el-nikitos/UAK/UAK_0/PNG/UAK_1A_Back.png

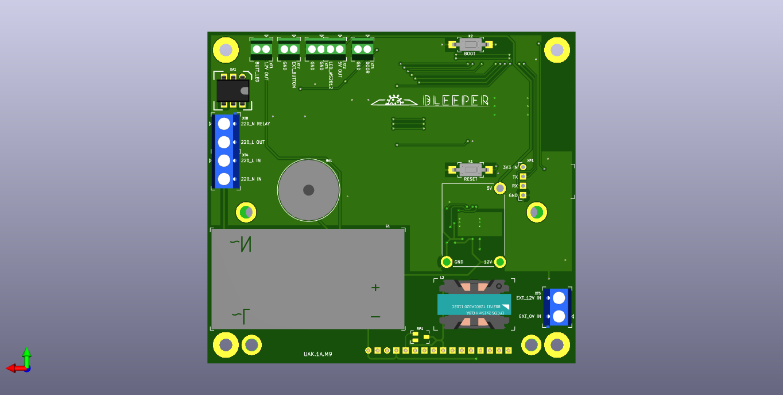
UAK_0/PNG/UAK_1A_Back.png
