el-nikitos/UAK/UAK_0/PNG/UAK_0B_Back.png

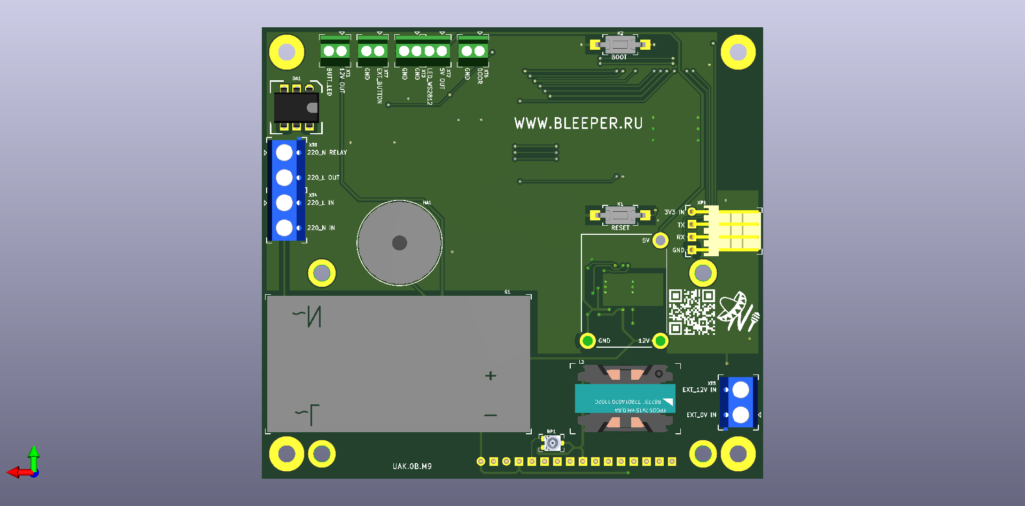
UAK_0/PNG/UAK_0B_Back.png
