el-nikitos/UAK/заводские номера/uak-1с.docx

uak-1c-1m0
uak-1c-2m0
uak-1c-3m0
uak-1c-4m0

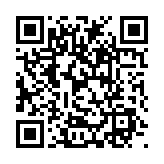
[picture p15: figure]

uak-1c-5m0

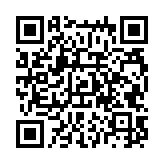
[picture p16: figure]

uak-1c-6m0

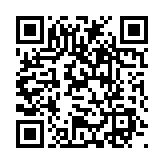
[picture p17: figure]

uak-1c-7m0

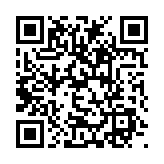
[picture p18: figure]

uak-1c-8m0

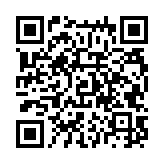
[picture p19: figure]

uak-1c-9m0
