el-nikitos/UAK/UAK_0/PNG/UAK_0_F_preview.png

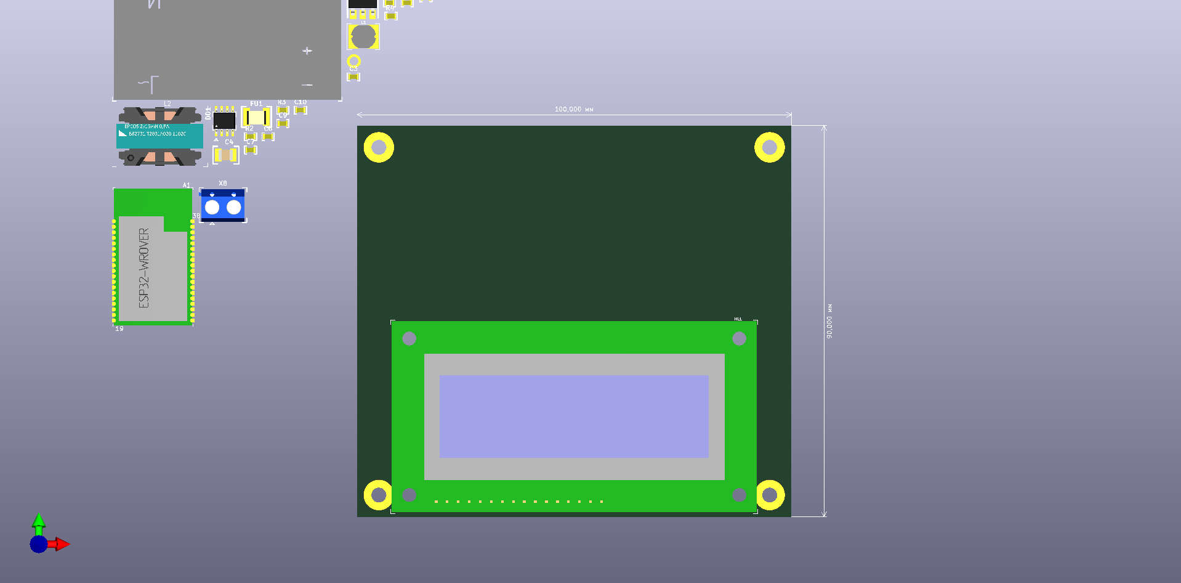
UAK_0/PNG/UAK_0_F_preview.png
