el-nikitos/UAK/UAK_0/PNG/UAK_0B_Front-noLCD.png

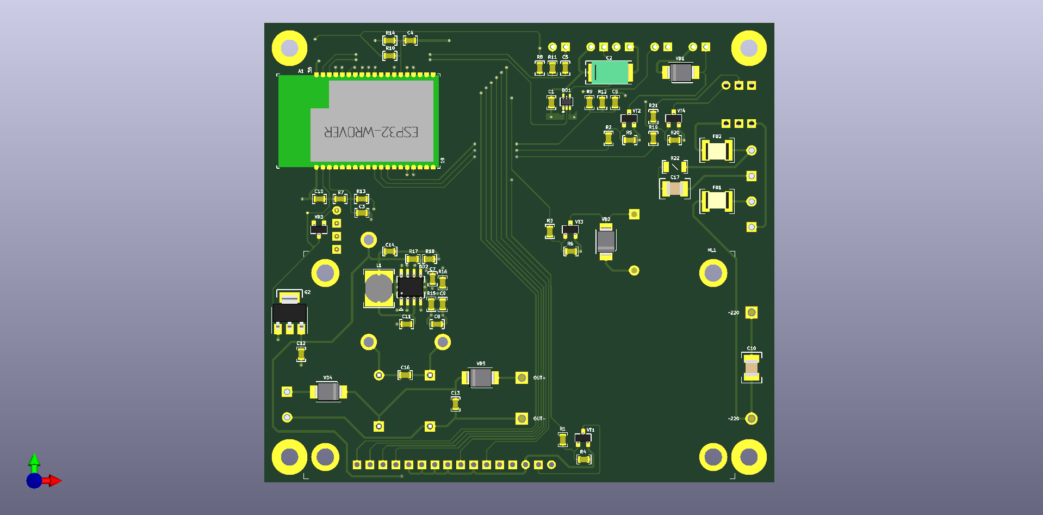
UAK_0/PNG/UAK_0B_Front-noLCD.png
