el-nikitos/UAK/UAK_0/PNG/UAK_0B_Front-withLCD.png

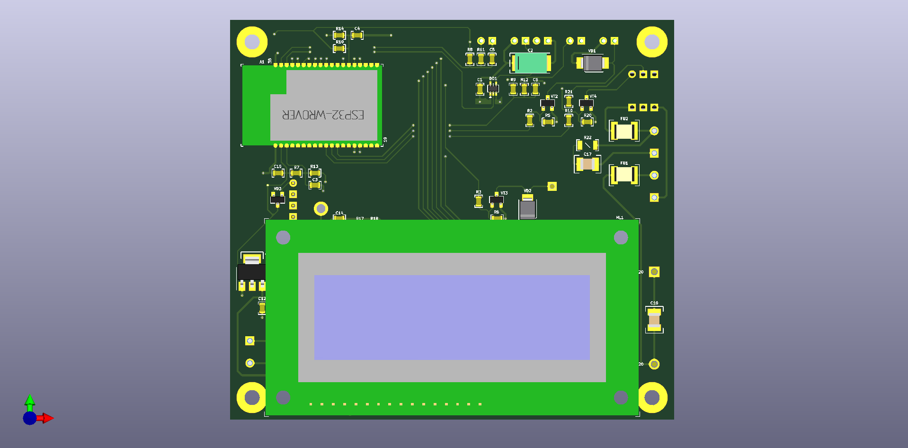
UAK_0/PNG/UAK_0B_Front-withLCD.png
