el-nikitos/UAK/UAK_1/PNG/UAK_1C_B.png

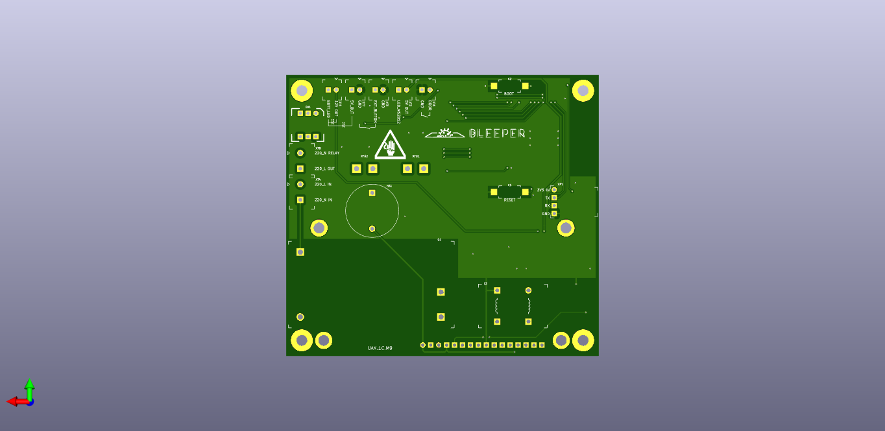
UAK_1/PNG/UAK_1C_B.png
