el-nikitos/UAK/документация/UAK_1C/UAK_1С СБ.png

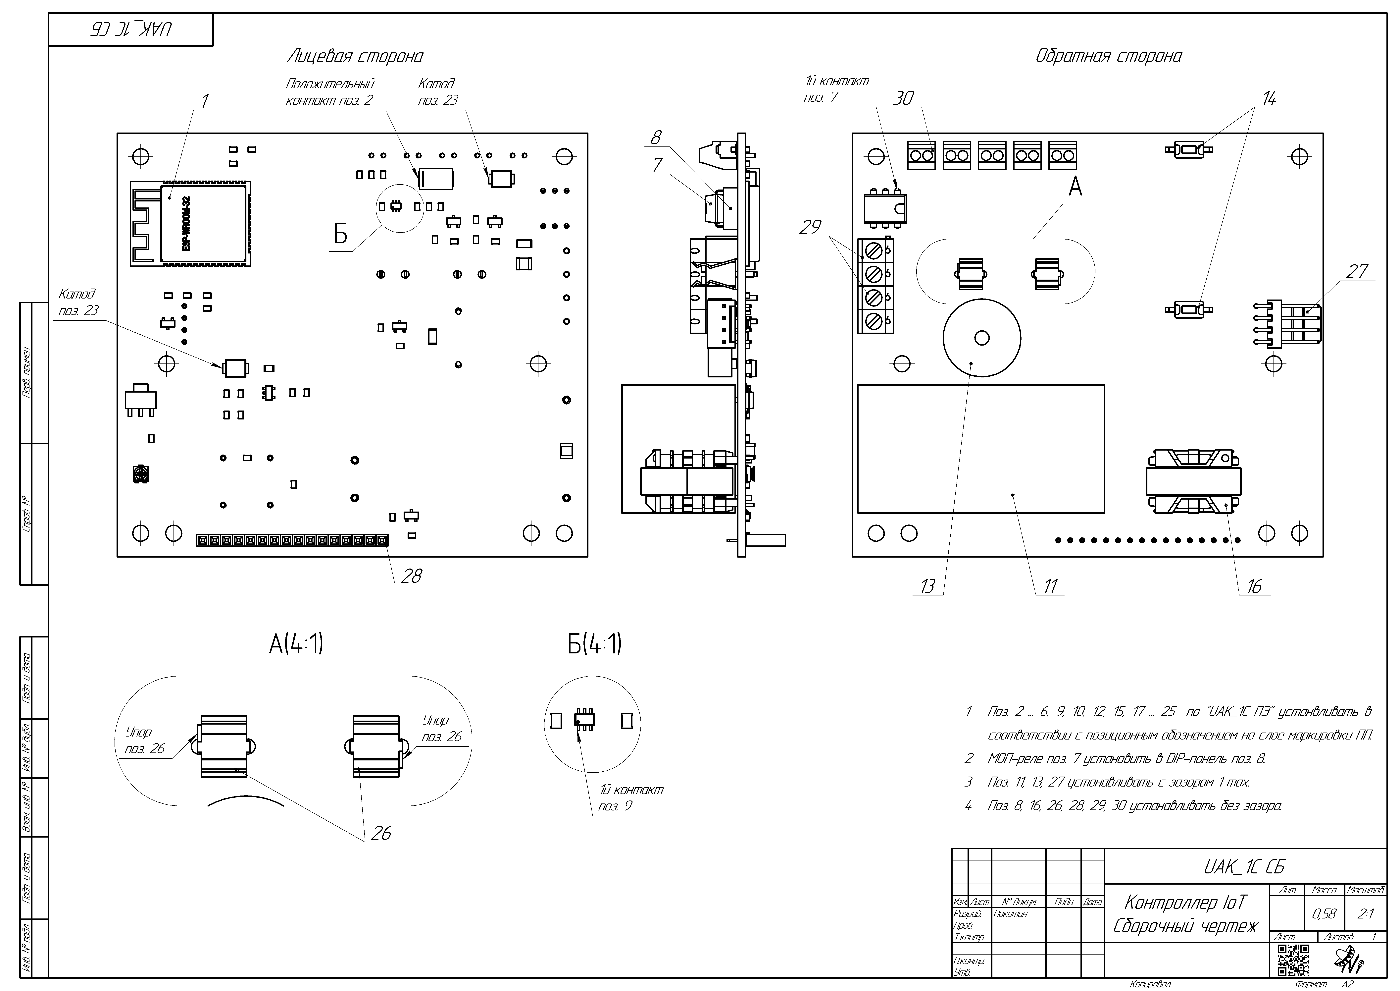
документация/UAK_1C/UAK_1С СБ.png
