el-nikitos/UAK/документация/UAK_2B/UAK_2B СБ изм.1.png

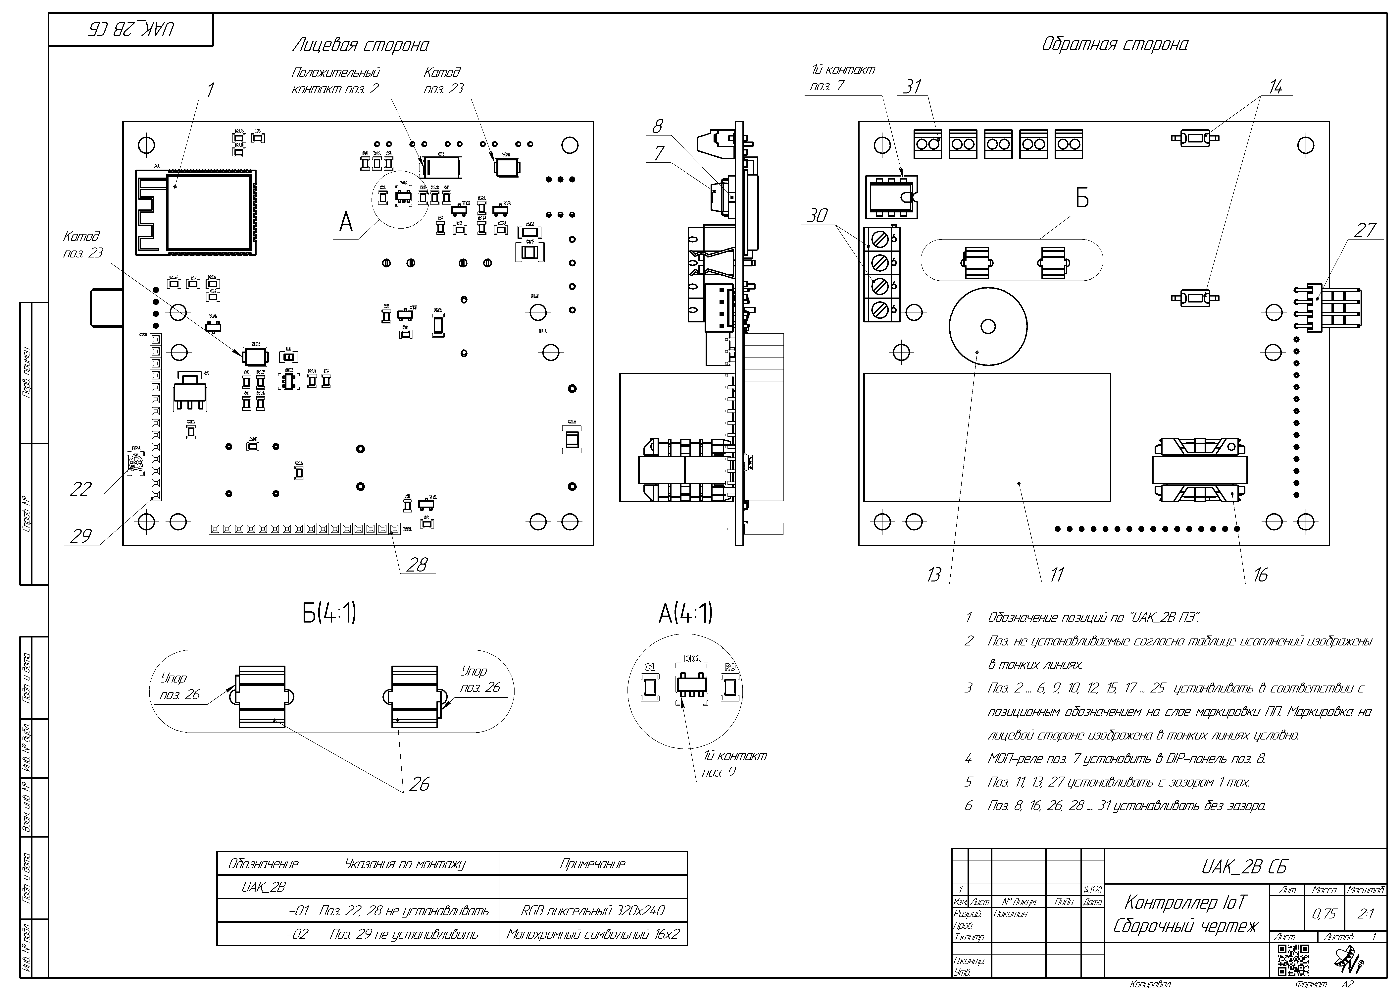
документация/UAK_2B/UAK_2B СБ изм.1.png
