el-nikitos/UAK/ИД/исходная схема.jpeg

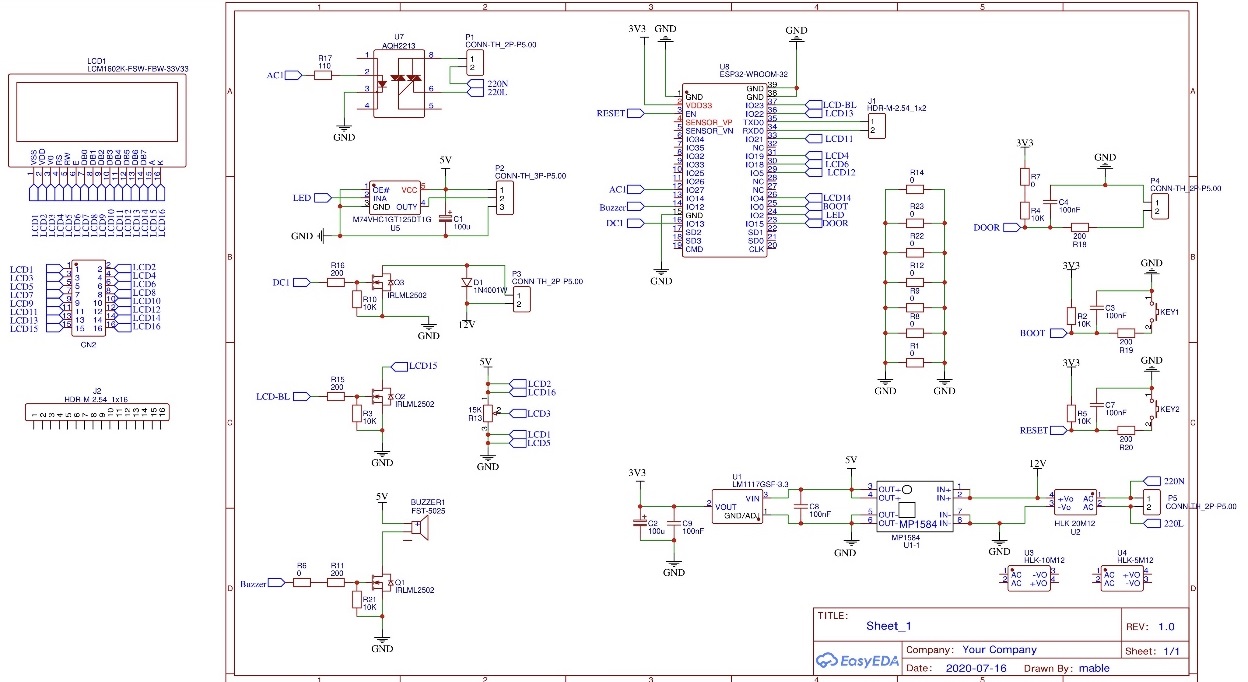
ИД/исходная схема.jpeg
