el-nikitos/UAK/ИД/эскиз расположения 1.jpeg

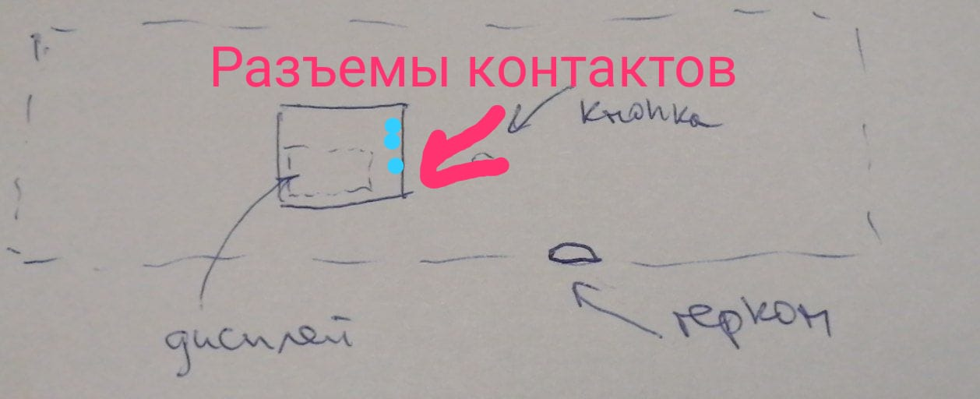
ИД/эскиз расположения 1.jpeg
