el-nikitos/UAK/ИД/эскиз расположения 2.jpeg

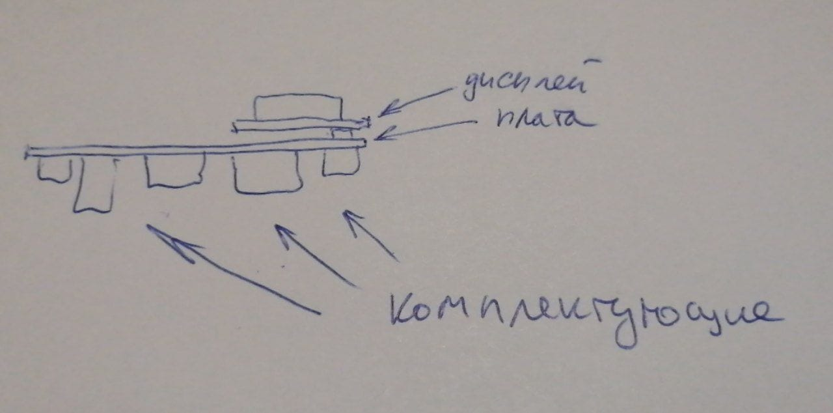
ИД/эскиз расположения 2.jpeg
