el-nikitos/UAK/UAK_3/заказ/JLCSMT_UAK_3A_N5_BOM1.xlsx

Sheet: UAK_3A_N5
Comment | Designator | Footprint | LCSC Part #（optional）
ESP32-WROOM-32E | A1 | SMD38,18x25.5 | C701341
100nF 50V | C1 | 0603_C | C14663
100uF 10V | C2 | CASE-D_7343 | C110548
100nF 50V | C3 | 0603_C | C14663
100nF 50V | C4 | 0603_C | C14663
100nF 50V | C5 | 0603_C | C14663
100nF 50V | C6 | 0603_C | C14663
22nF 1kV | C7 | 1210_C | C304015
10uF 10V | C8 | 0603_C | C19702
10uF 10V | C9 | 0603_C | C19702
10uF 10V | C10 | 0603_C | C19702
10uF 10V | C11 | 0603_C | C19702
M74VHC1GT125DT1G | DD1 | SOT-23-5 | C23654
SC1117-3.3V | G2 | SOT-223 | C173386
240Ω | R1 | 0603_R | C23350
10kΩ | R2 | 0603_R | C25804
150Ω | R3 | 0603_R | C22808
130Ω | R4 | 2010_R | C25459
240Ω | R5 | 0603_R | C23350
240Ω | R6 | 0603_R | C23350
240Ω | R7 | 0603_R | C23350
240Ω | R8 | 0603_R | C23350
240Ω | R9 | 0603_R | C23350
240Ω | R10 | 0603_R | C23350
240Ω | R11 | 0603_R | C23350
240Ω | R12 | 0603_R | C23350
240Ω | R13 | 0603_R | C23350
10kΩ | R14 | 0603_R | C25804
10kΩ | R15 | 0603_R | C25804
10kΩ | R16 | 0603_R | C25804
1kΩ | R17 | 1206_R | C4410
10kΩ | R18 | 0603_R | C25804
10kΩ | R19 | 0603_R | C25804
10kΩ | R20 | 0603_R | C25804
10kΩ | R21 | 0603_R | C25804
240Ω | R22 | 0603_R | C23350
240Ω | R23 | 0603_R | C23350
240Ω | R24 | 0603_R | C23350
240Ω | R25 | 0603_R | C23350
50K Variable Resistors | RP1 | 3314J | C50895
MDD SS24B | VD1 | SMB(DO-214AA) | C78395
BAT54CLT1G | VD2 | SOT-23-3 | C68978
IRLML6344TR | VT1 | SOT-23-3 | C8545
IRLML6344TR | VT2 | SOT-23-3 | C8545
IRLML6344TR | VT3 | SOT-23-3 | C8545
IRLML6344TR | VT4 | SOT-23-3 | C8545

Sheet: sample
Comment | Designator | Footprint | LCSC Part #（optional）
100uF | C1 | CASE-B_3528 | C16133
100nF | C2, C9, C10 | 0603_C | C14663
10uF | C3-5 | 1206_C | C13585
15KΩ | R5, R6 | 0603_R | C22809
