el-nikitos/UAK/UAK_2/BOM/BOM_UAK_2B.xlsx

Позиционное обозначение | Ссылка для справки | Наименование | Кол-во | Сторона установки | Метод установки | кол-во на 50+10%
A1 | https://www.terraelectronica.ru/product/2292549 | ESP32-WROOM-32 [4MB] | 1 | лицевая | поверхностный | 55
C2 | https://www.terraelectronica.ru/product/363479 | Конденсатор D 100 мкФ 10В 20% | 1 | лицевая | поверхностный | 55
> C1, C3-C6 | https://www.terraelectronica.ru/product/1044009 | Конденсатор 0603 100 нФ 50В 5% | 5 | лицевая | поверхностный | 262.5
C8 | https://www.terraelectronica.ru/product/664080 | Конденсатор 0603 220 пФ 50В 5% | 1 | лицевая | поверхностный | 55
> C7, C9, C12, C13, C15, C16 | https://www.terraelectronica.ru/product/1489875 | Конденсатор 0603 10 мкФ 25В 20% | 6 | лицевая | поверхностный | 315
> C10, C17 | https://www.chipdip.ru/product/grm32qr72j223k | Конденсатор 1210 0,022 мкФ 630В 10% | 2 | лицевая | поверхностный | 110
DA1 | https://www.chipdip.ru/product/kr293kp1b | МОП-реле КР293КП1Б | 1 | обратная | в панель DA1* | 55
DA1* | https://www.chipdip.ru/product/trs-6 | DIP-панель | 1 | обратная | выводной | 55
DD1 | https://www.terraelectronica.ru/product/287011 | Повторитель M74VHC1GT125DT1G | 1 | лицевая | поверхностный | 55
DD2 | https://www.terraelectronica.ru/product/287900 | DC-DC LM27313XMF/NOPB | 1 | лицевая | поверхностный | 55
G1 | https://www.chipdip.ru/product/irm-15-5 | AC-DC IRM-15-5 | 1 | обратная | выводной | 55
G2 | https://www.chipdip.ru/product/lm1117gs-3.3 | LDO LM1117GS-3.3 | 1 | лицевая | поверхностный | 55
HA1 | https://www.chipdip.ru/product/hpa17f | Зуммер HPA17F | 1 | обратная | выводной | 55
> K1, K2 | https://www.terraelectronica.ru/product/1087727 | Кнопка FSMSM | 2 | обратная | поверхностный | 110
L1 | https://www.chipdip.ru/product/mlz2012m100ht000-10 | Чип-индуктивность 0805 10 мкГн 0,2А 20% | 1 | лицевая | поверхностный | 55
L2 | https://www.chipdip.ru/product/b82731-t2132-a20 | Дроссель B82731-T2132-A20 | 1 | обратная | выводной | 55
> R4-R10, R15, R16, R20 | https://www.terraelectronica.ru/product/562124 | Резистор 0603 10 кОм 5% | 10 | лицевая | поверхностный | 550
> R1-R3, R11-R14, R19 | https://www.terraelectronica.ru/product/559067 | Резистор 0603 240 Ом 5% | 8 | лицевая | поверхностный | 440
R17 | https://www.terraelectronica.ru/product/2782214 | Резистор 0603 82 кОм 5% | 1 | лицевая | поверхностный | 55
R21 | https://www.terraelectronica.ru/product/569439 | Резистор 0603 150 Ом 5% | 1 | лицевая | поверхностный | 55
> R22, R23 | https://www.terraelectronica.ru/product/2782734 | Резистор 1206 4,7 кОм 5% | 2 | лицевая | поверхностный | 110
RP1 | https://www.chipdip.ru/product/3303x-3-503 | Резистор подстроечный 50 кОм | 1 | лицевая | поверхностный | 55
> VD1, VD2 | https://www.terraelectronica.ru/product/129173 | Диод шоттки SK16 (1А 60В) | 2 | лицевая | поверхностный | 110
VD3 | https://www.terraelectronica.ru/product/296487 | Набор диодов BAR43CFILM | 1 | лицевая | поверхностный | 55
> VT1-VT4 | https://www.chipdip.ru/product/irlml6344trpbf | Транзистор N-канал IRLML6344TRPBF | 4 | лицевая | поверхностный | 220
> XFU1, XFU2 | https://www.chipdip.ru/product/kls5-266-fh-100 | Держатель KLS5-266 | 2 | обратная | выводной | 110
XP1 | https://www.chipdip.ru/product/wf-4r | Вилка угловая WF-4R | 1 | обратная | выводной | 55
XS1 | https://www.chipdip.ru/product/pbs16 | Розетка PBS-16 | 1 | лицевая | выводной | 55
XS2 | https://www.chipdip.ru/product/pbs-14 | Розетка PBS-14 | 1 | лицевая | выводной
> XT4, XT8 | https://www.chipdip.ru/product/kls2-300-5.00-02p-2s-dg300-5.0-02p-12 | Клеммник KLS2-300-5.00-02P-2S (шаг 5 мм) | 2 | обратная | выводной | 110
> XT1-XT3, XT6, XT7 | https://www.chipdip.ru/product/308-021-12-14 | Клеммник 308-021-14 (шаг 2,54 мм) | 5 | обратная | выводной | 262.5
