el-nikitos/UAK/оснастка/крышка предохранителя-2.stl

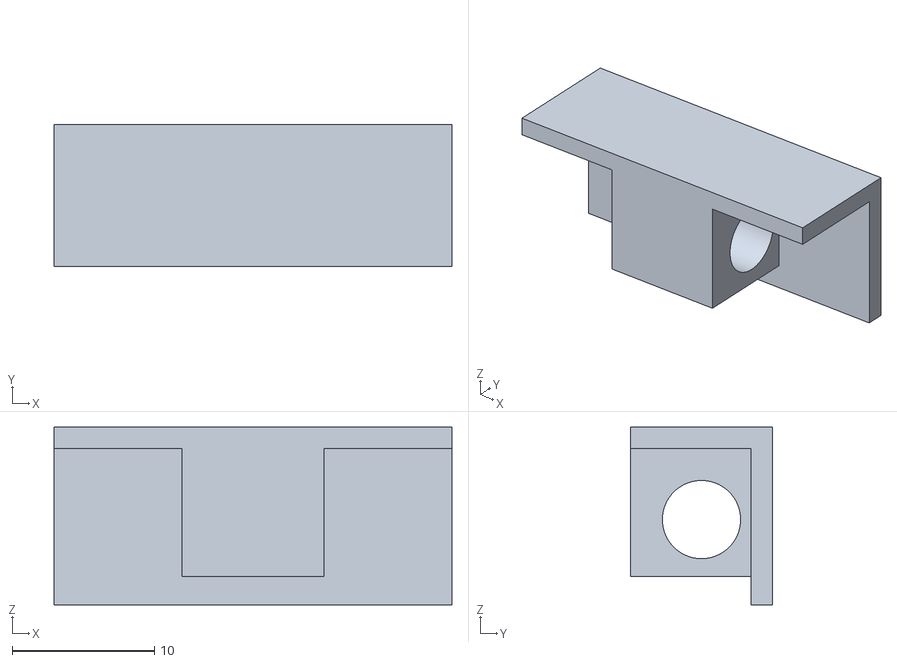
[picture p29: CAD file, 2020-11-04]
оснастка/крышка предохранителя-2.stl
28.0 x 10.0 x 12.5
