el-nikitos/UAK/оснастка/крышка предохранителя.stl

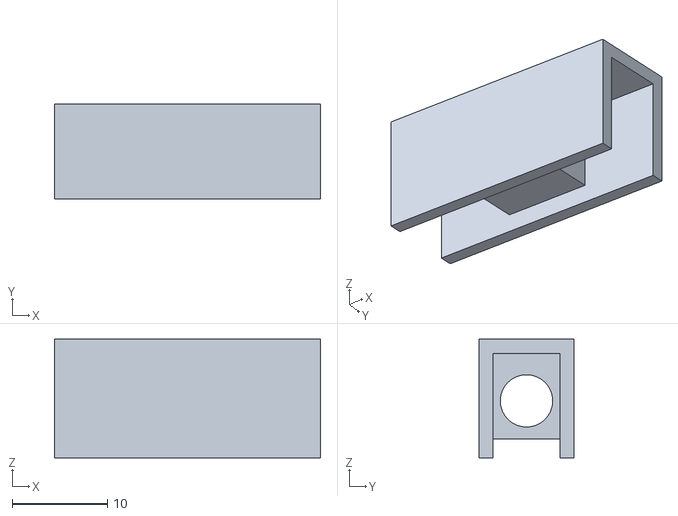
[picture p30: CAD file, 2020-10-17]
оснастка/крышка предохранителя.stl
28.0 x 10.0 x 12.5
