el-nikitos/UAK/(list of files, cad)

Other CAD files:
UAK_2/чертежи/UAK_2-B_SilkS.dxf
UAK_2/чертежи/UAK_2-F_SilkS.dxf
