el-nikitos/UAK/UAK_0/STEP/компас/UAC_0C общий вид.png

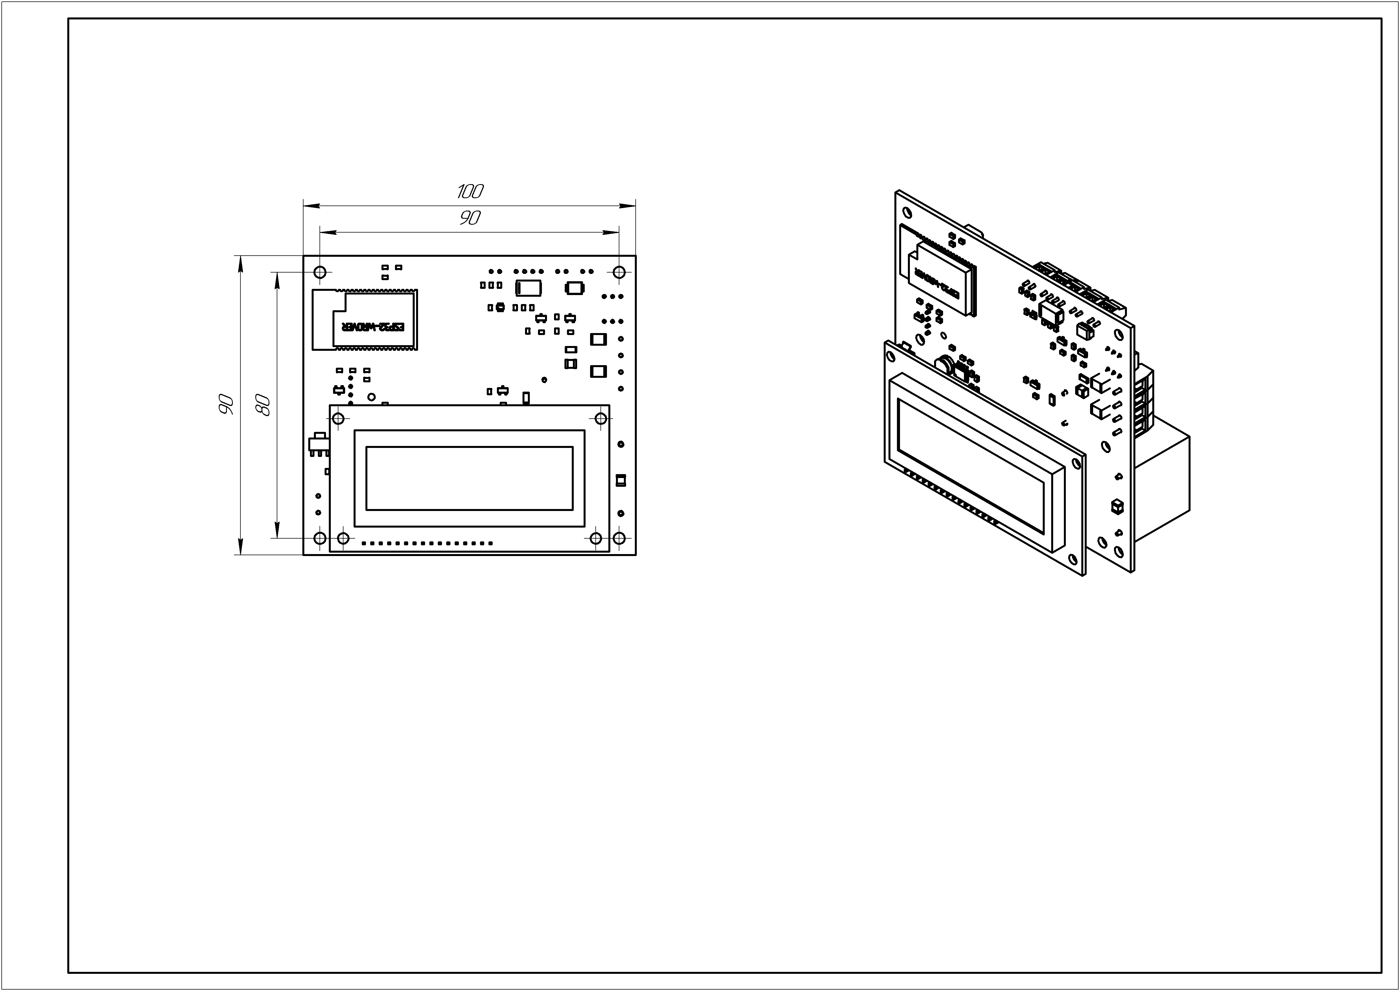
UAK_0/STEP/компас/UAC_0C общий вид.png
