el-nikitos/UAK/UAK_0/PDF/UAK_0C.pdf

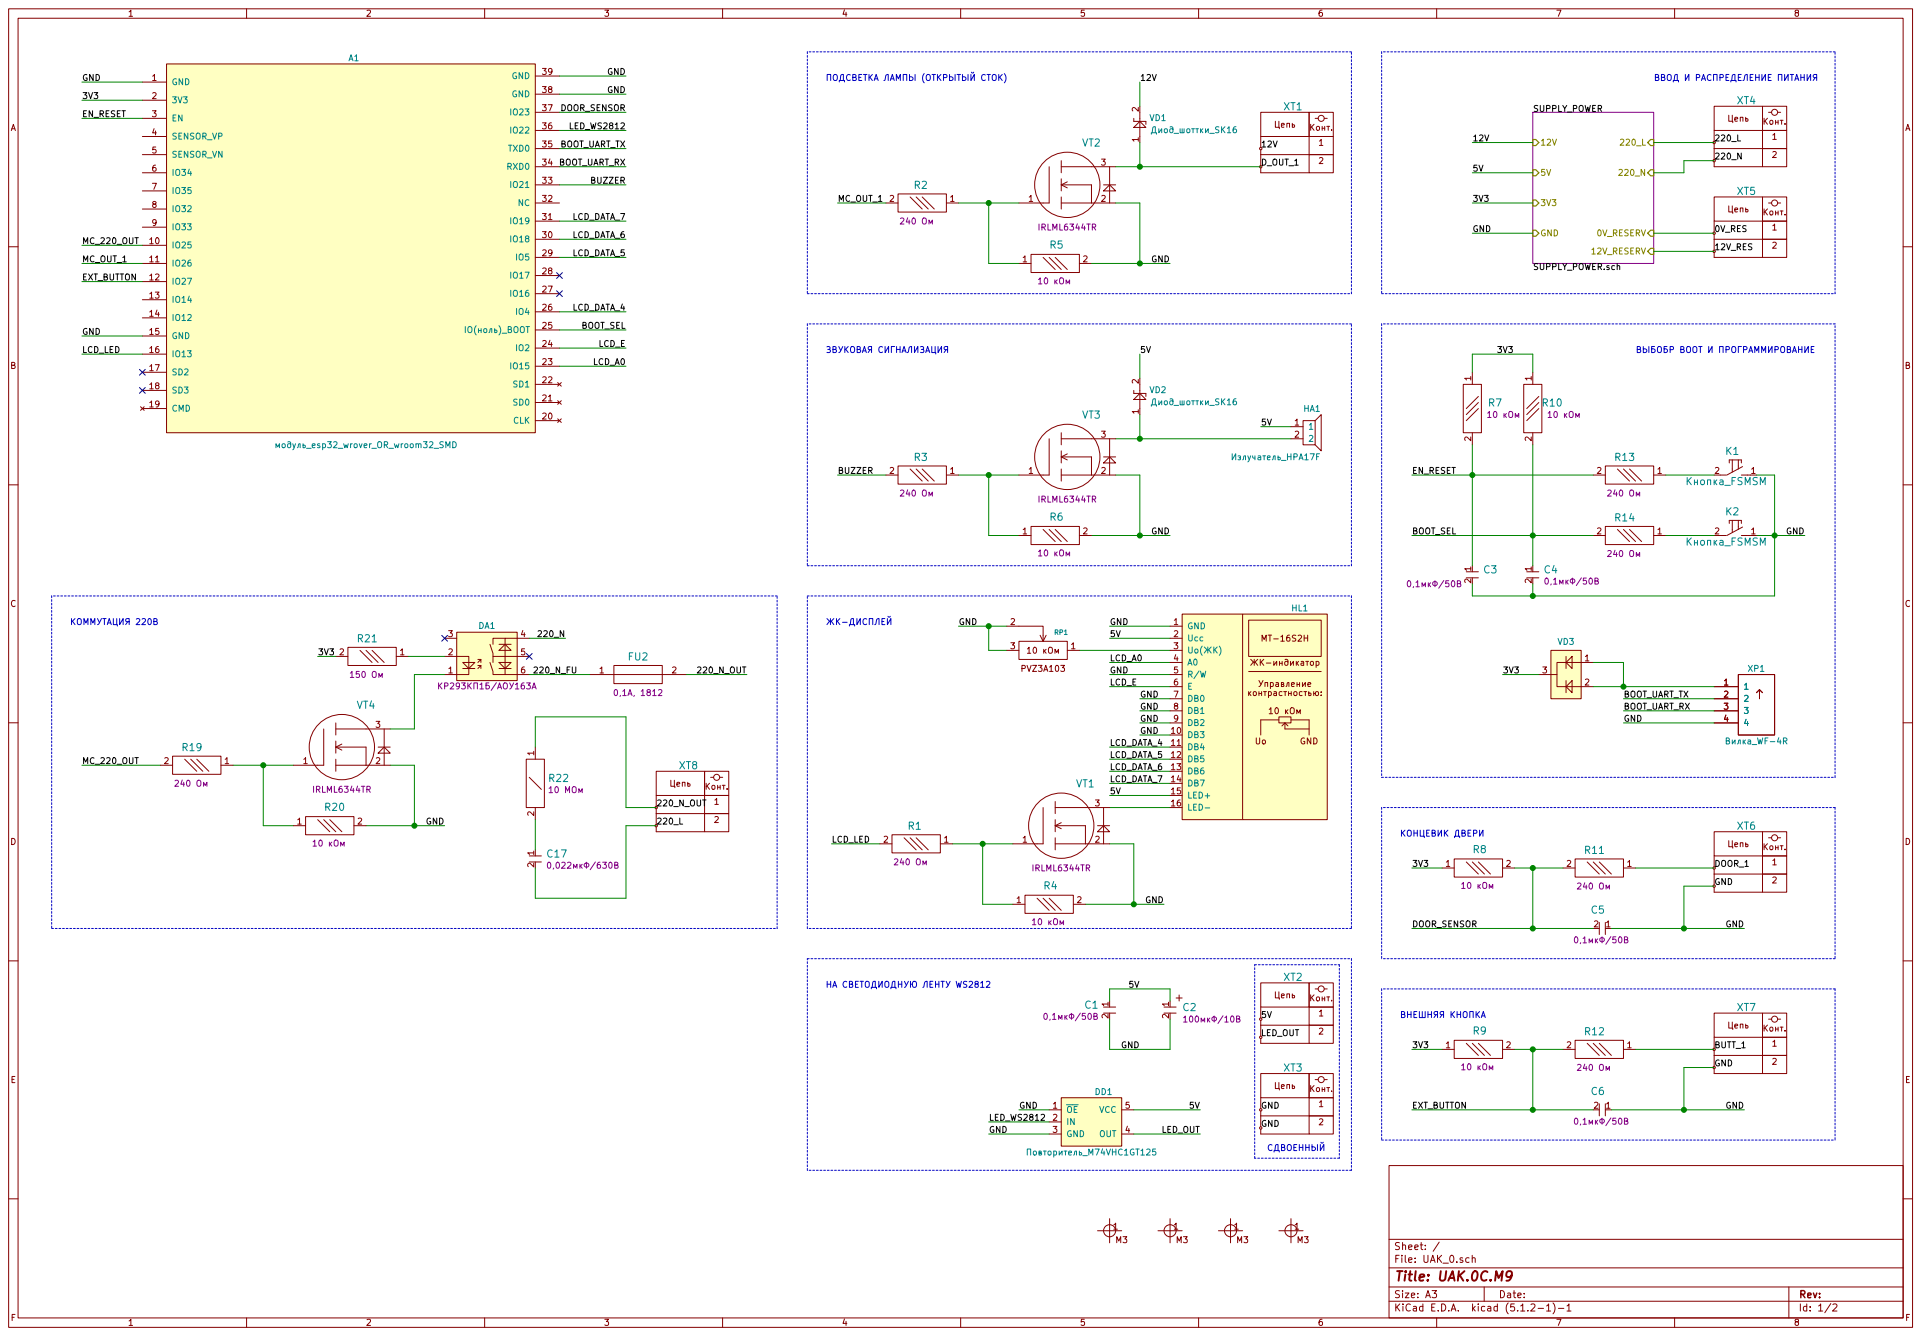
[picture p32: page 1]

. XT6 DOOR_1

. XT3 GND GND

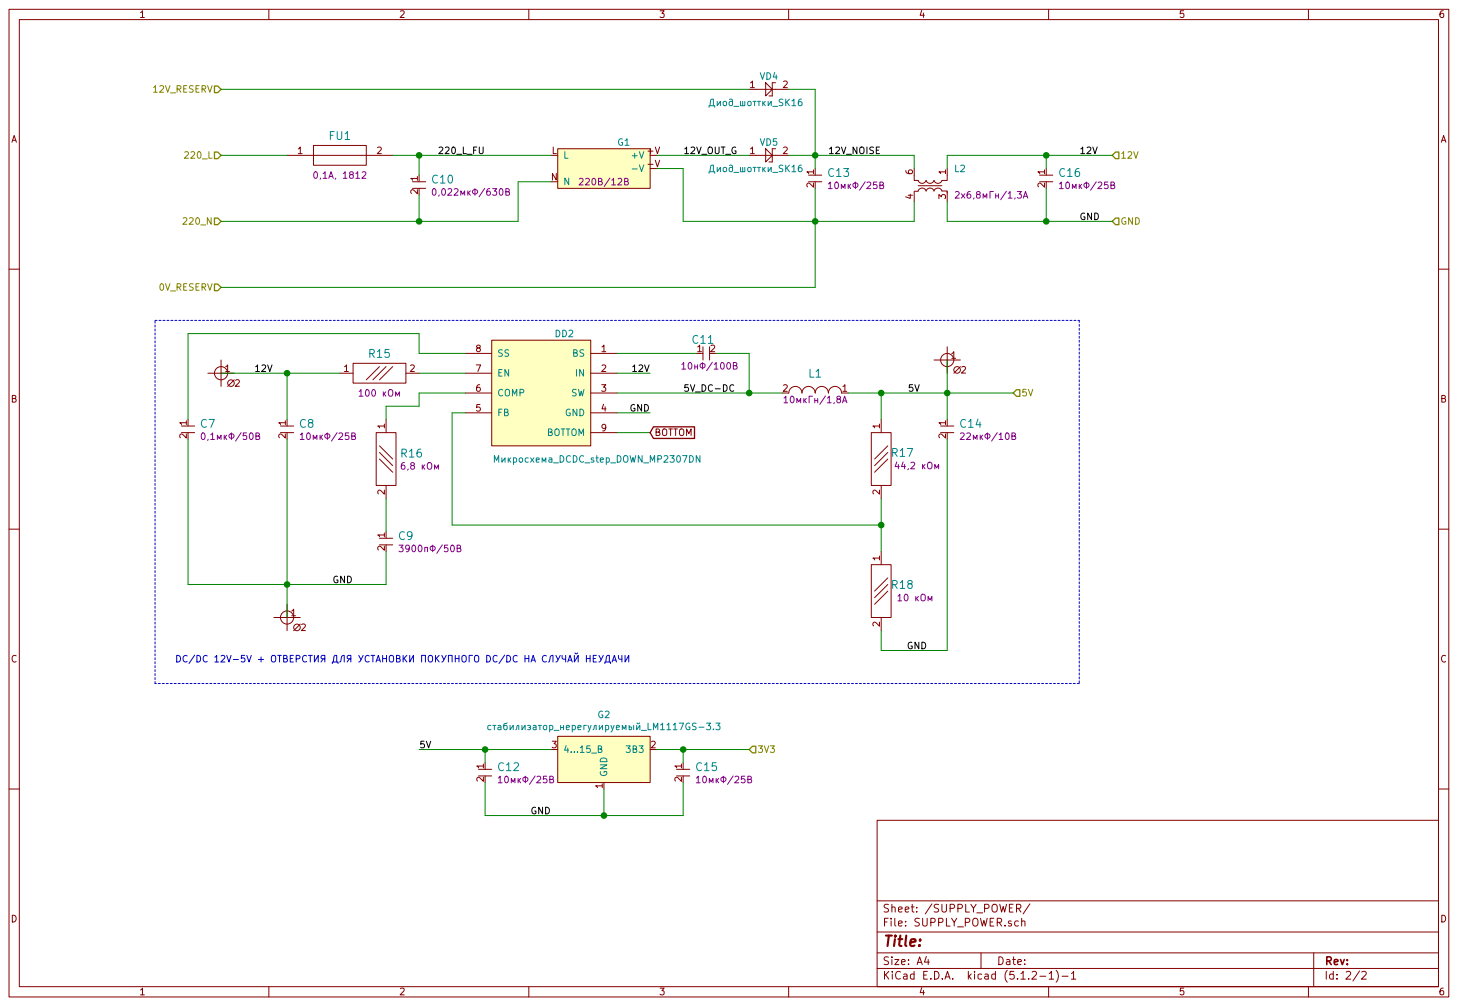
[picture p33: page 2]

0V_RESERV DC/DC 12V-5V + DC/DC
