el-nikitos/UAK/ИД/Schematic_timer-lamp-lcd-v2_2020-09-03_18-02-59.pdf

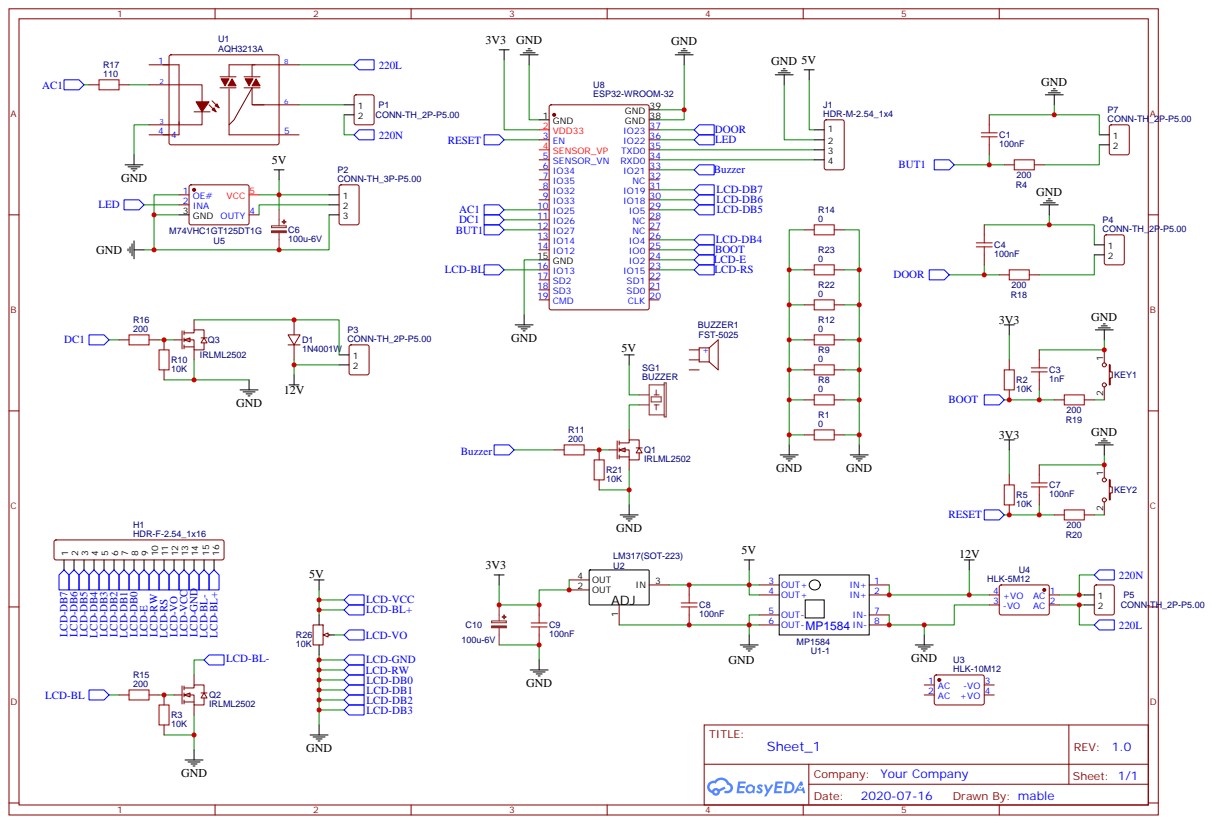
[picture p34: page 1]
