el-nikitos/UAK/UAK_2/PDF/UAK_2.pdf

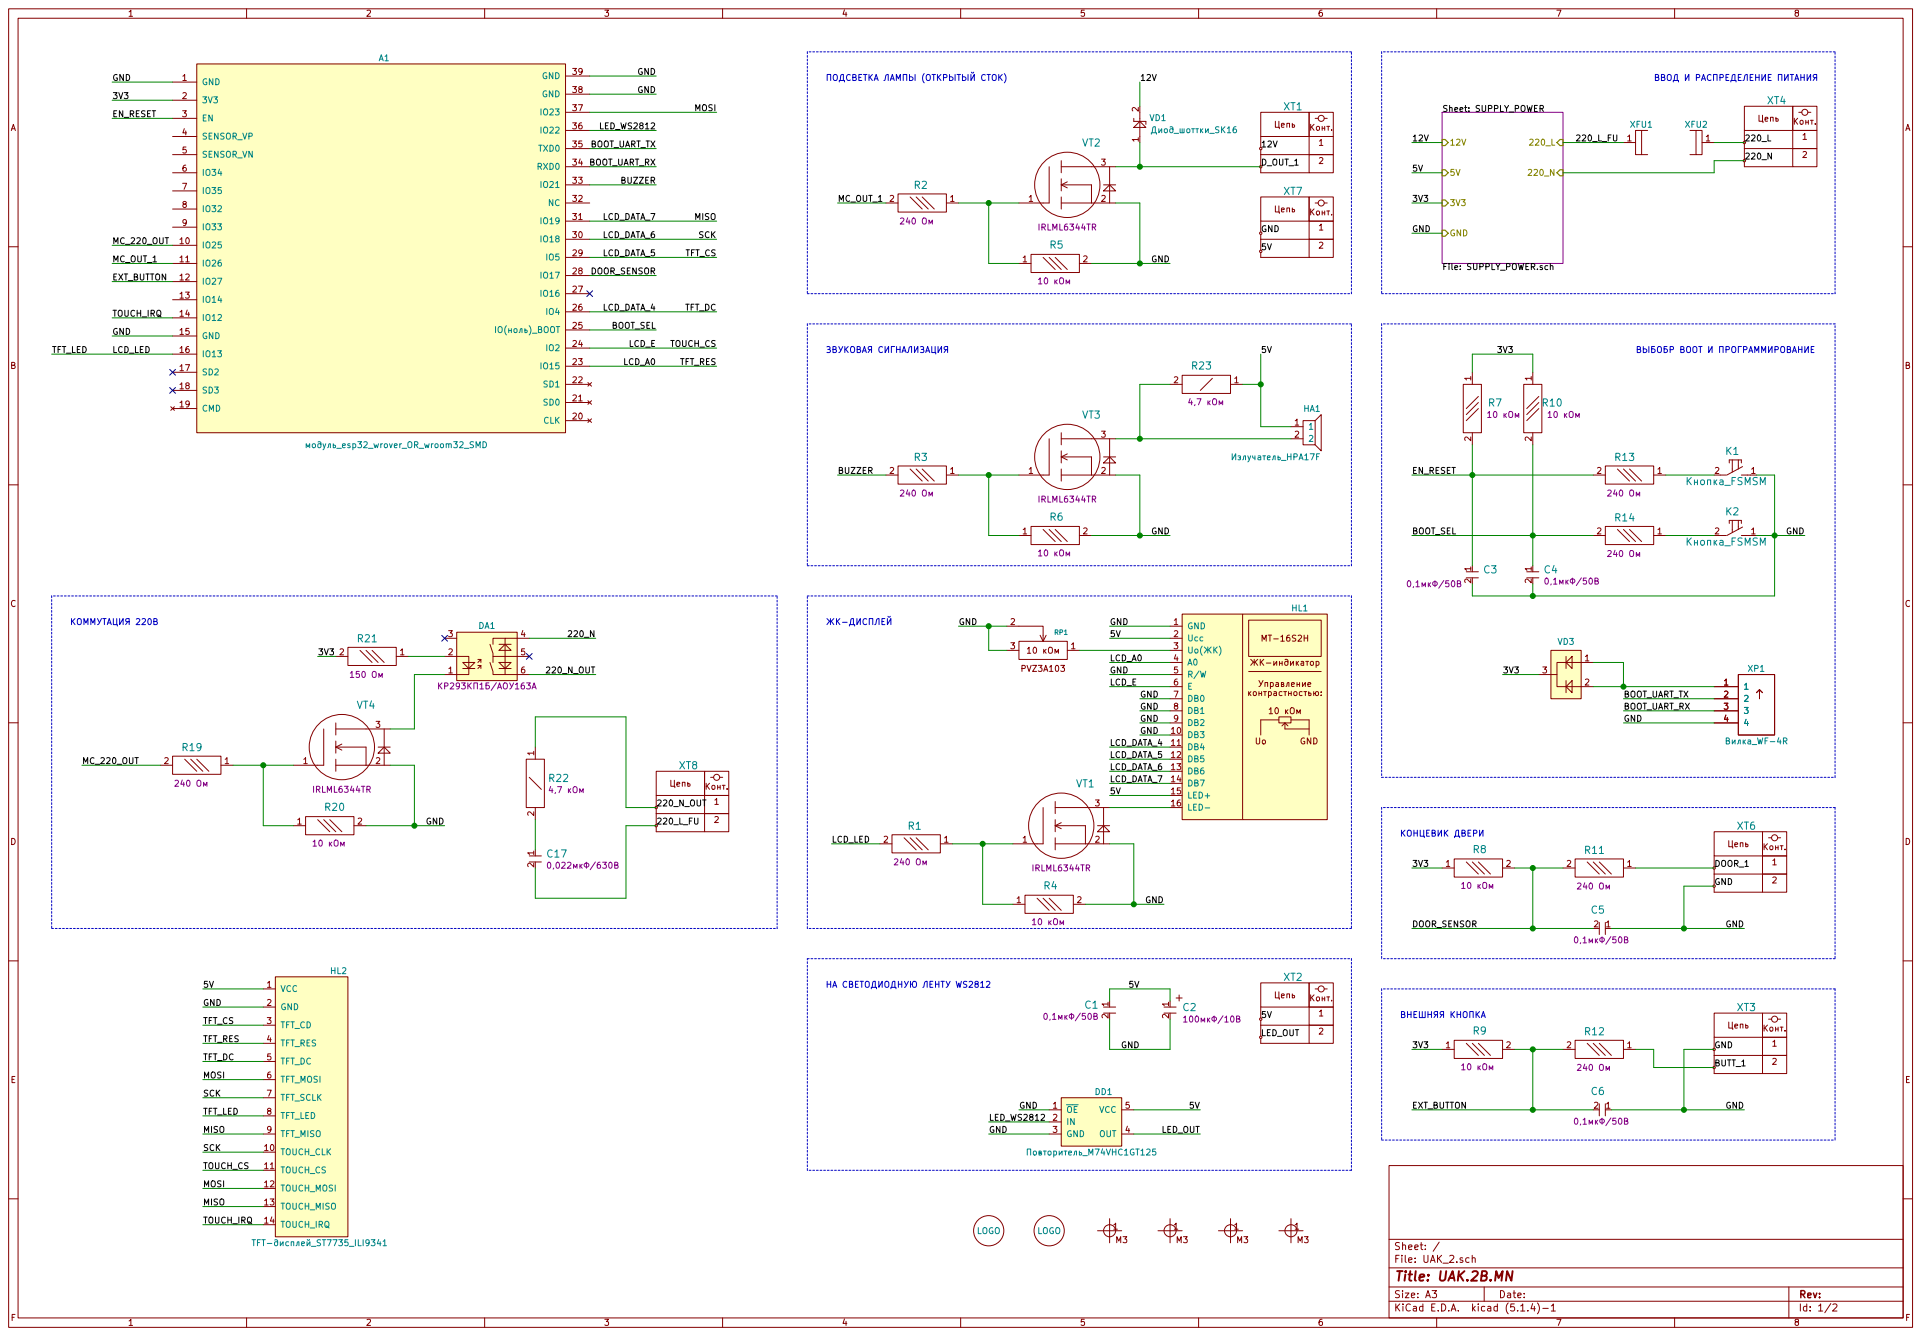
[picture p35: page 1]

File: UAK_2.sch Sheet: /
Id: 1/2 Title: UAK.2B.MN

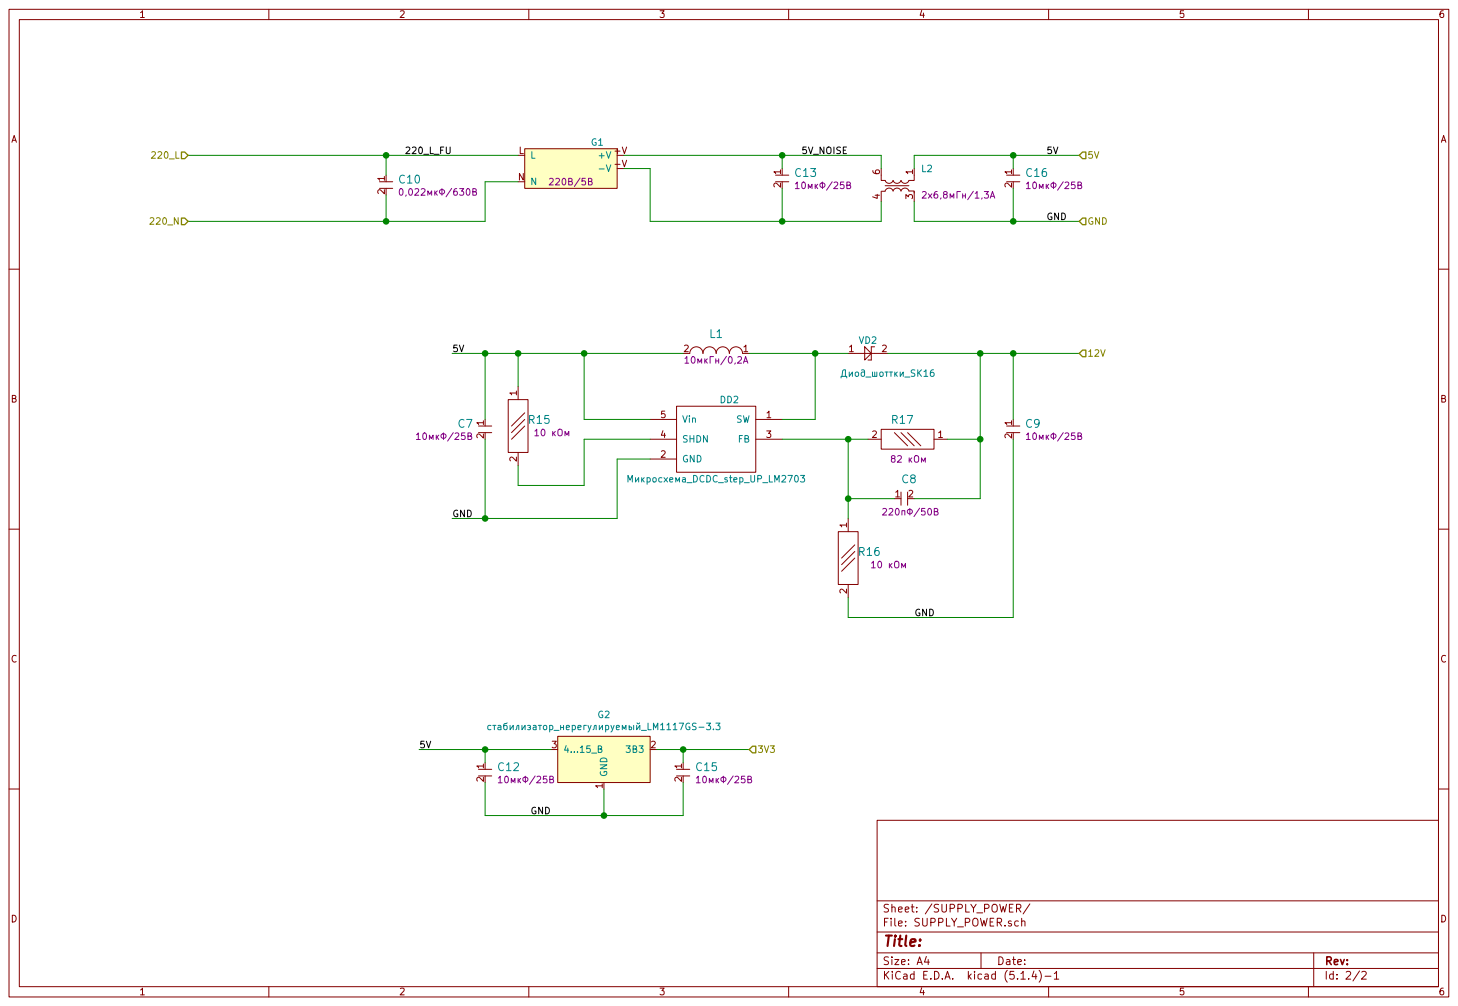
[picture p36: page 2]
