el-nikitos/UAK/UAK_0/PDF/UAK_0Сm.pdf

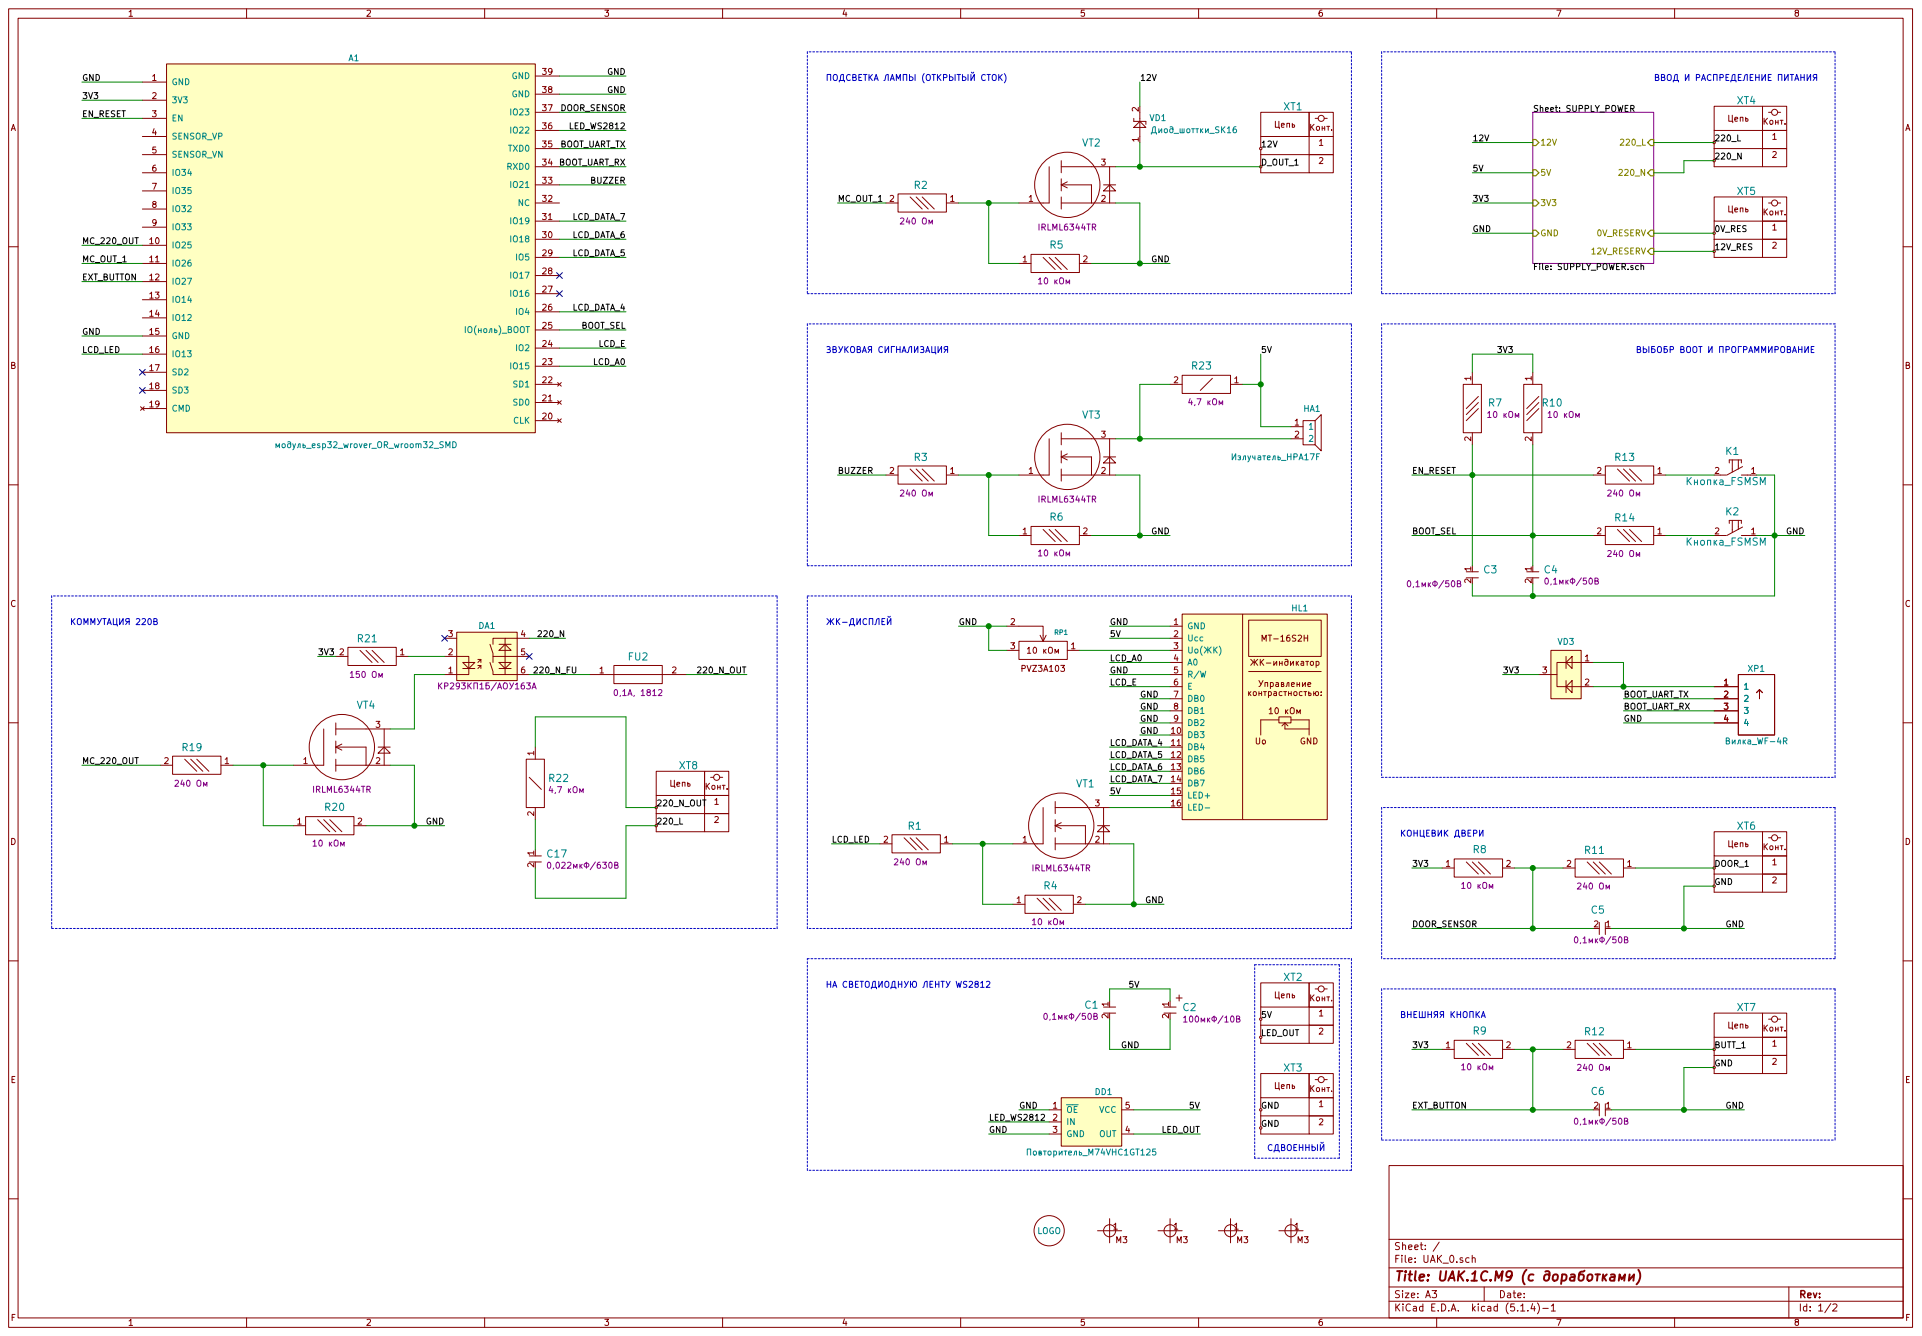
[picture p37: page 1]

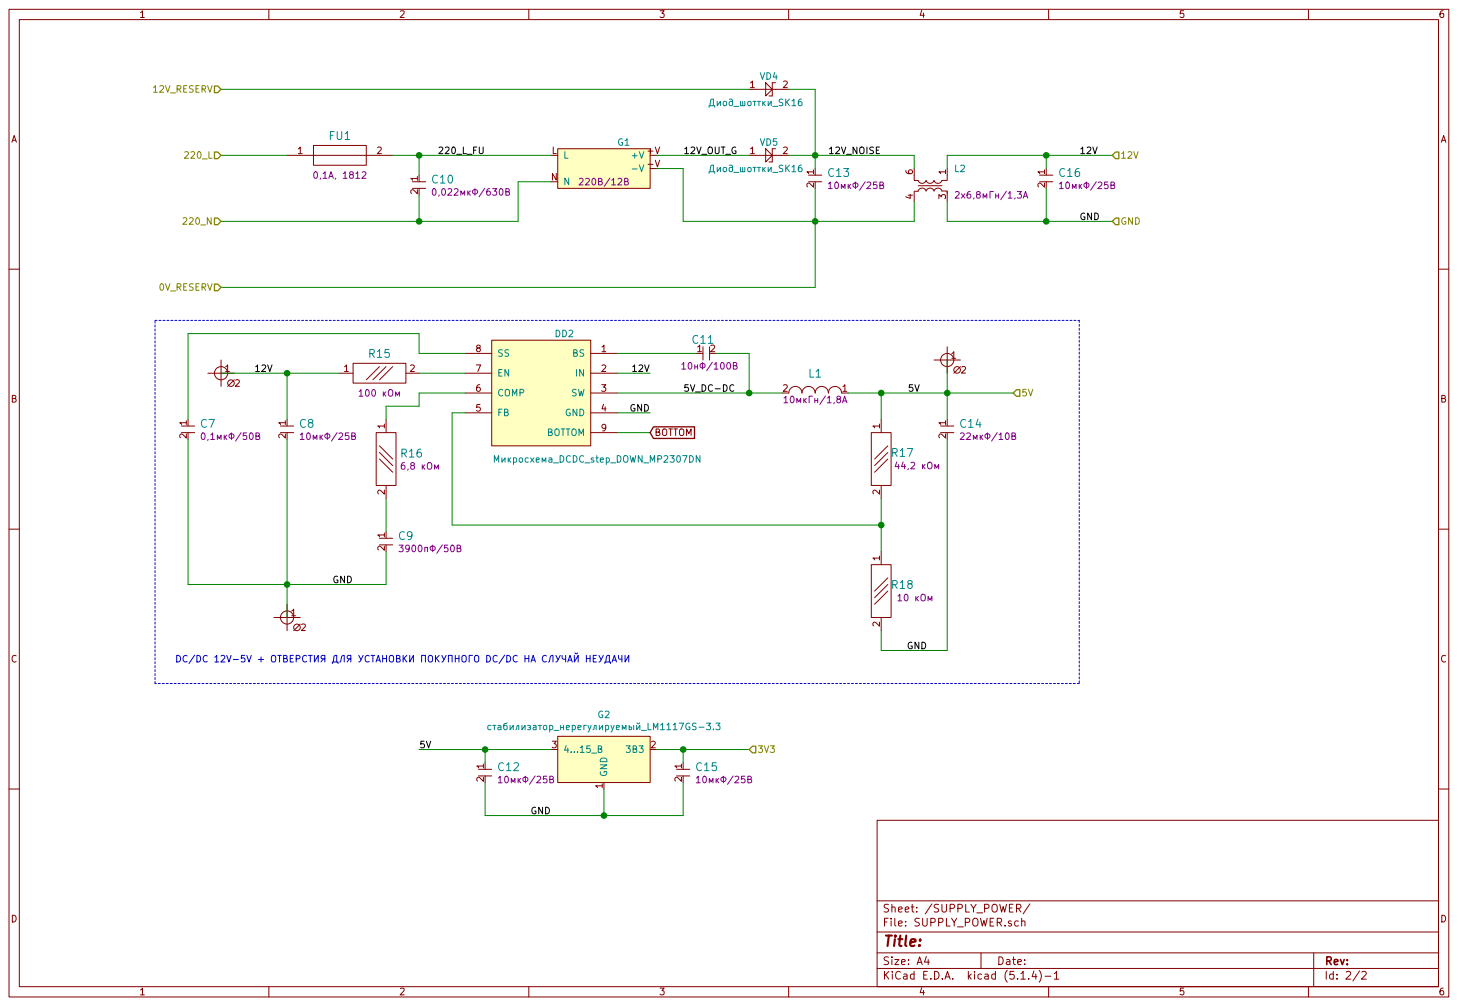
[picture p38: page 2]
