el-nikitos/UAK/UAK_1/PDF/UAK_1C.pdf

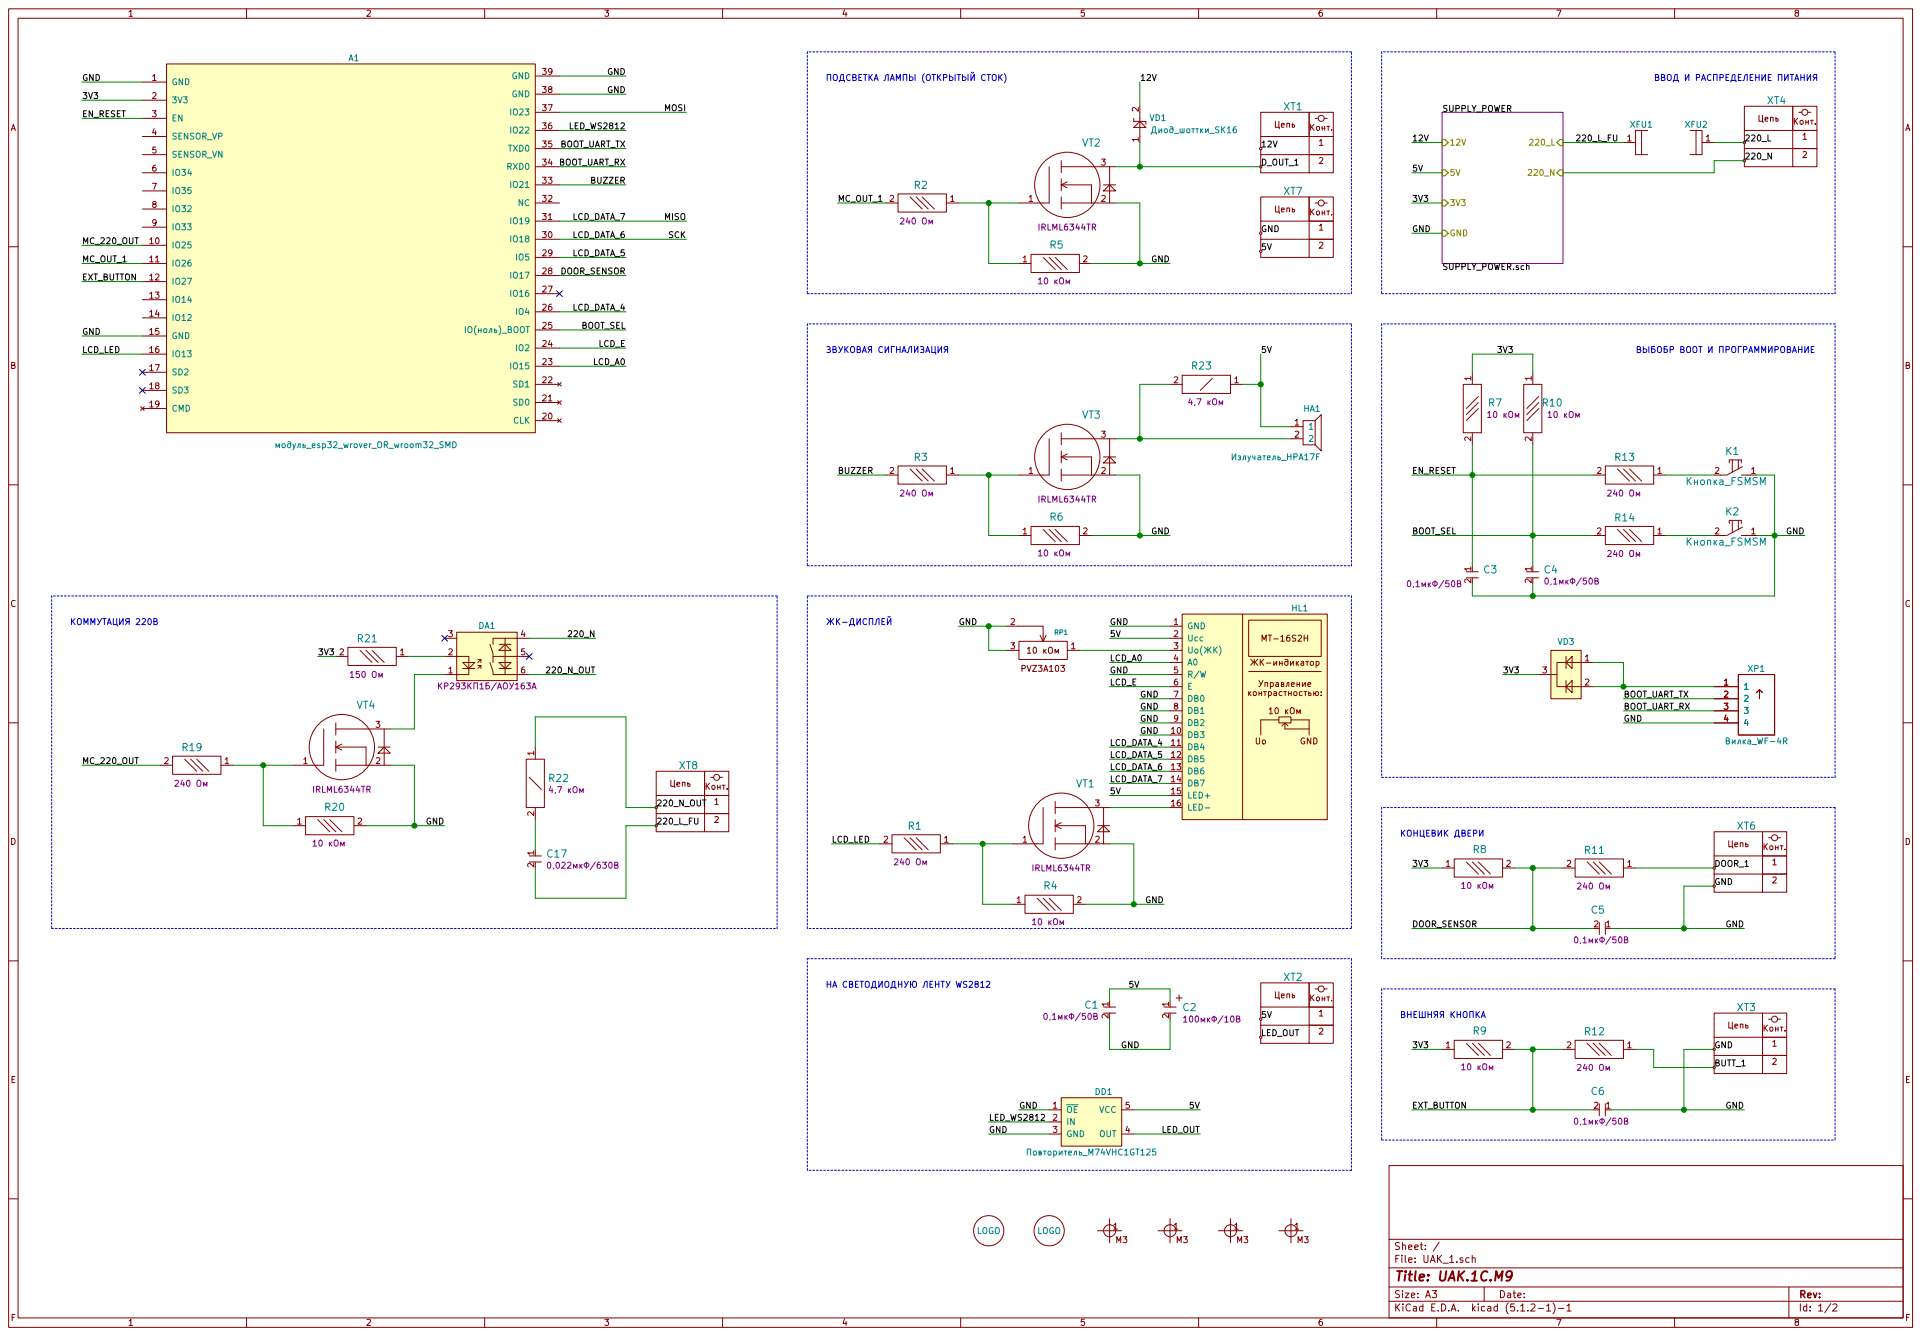
[picture p39: page 1]

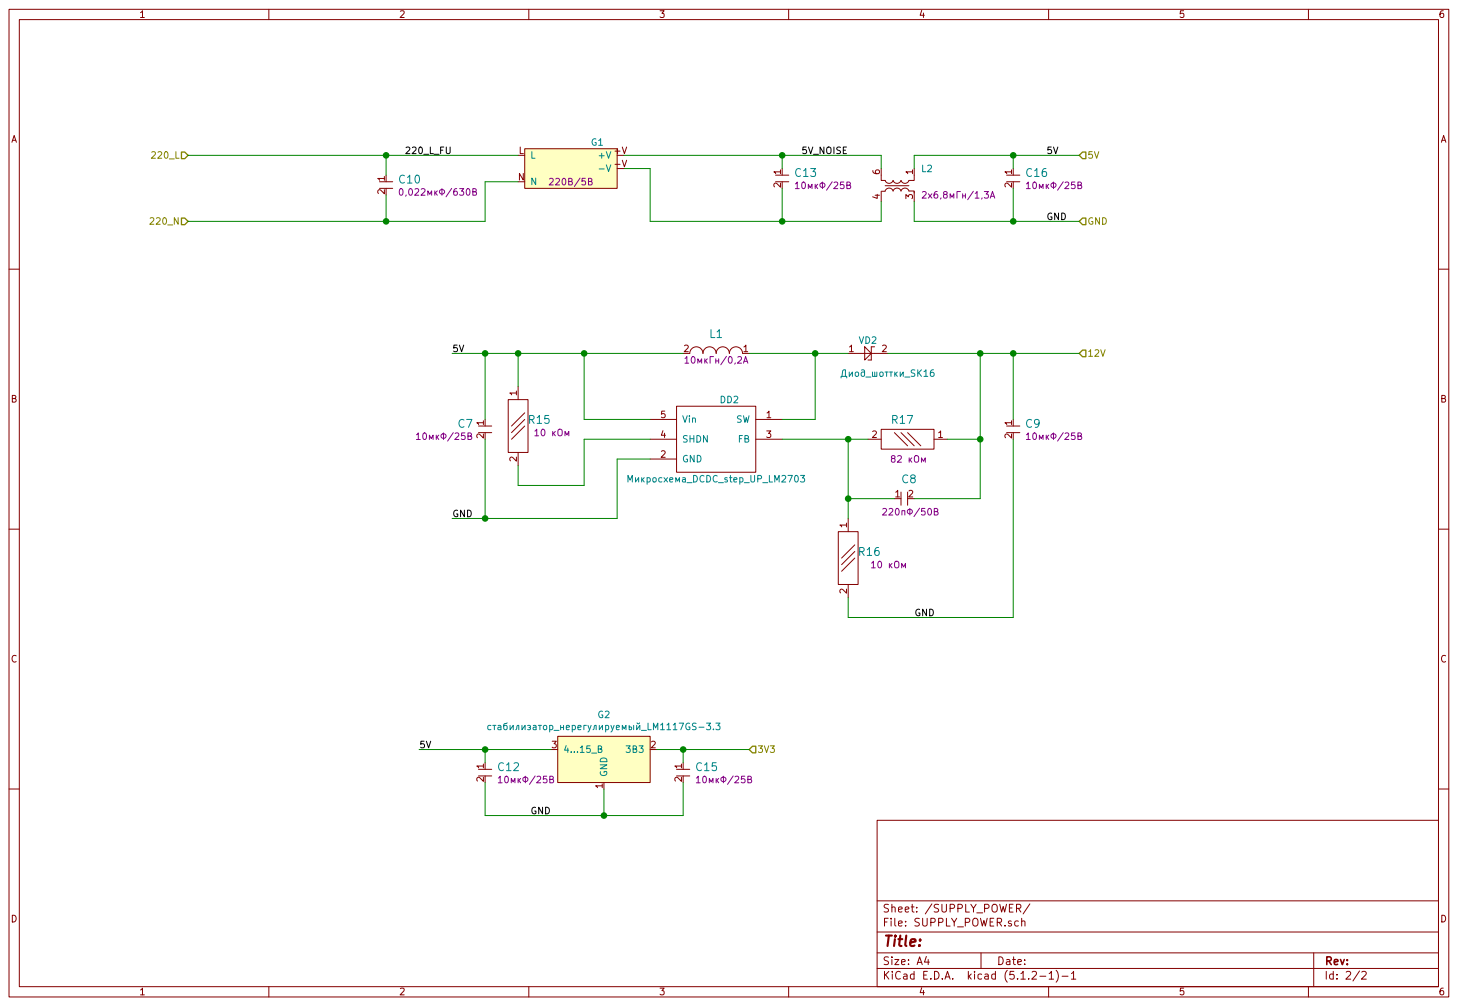
[picture p40: page 2]
