el-nikitos/UAK/UAK_0/PDF/UAK_0B.pdf

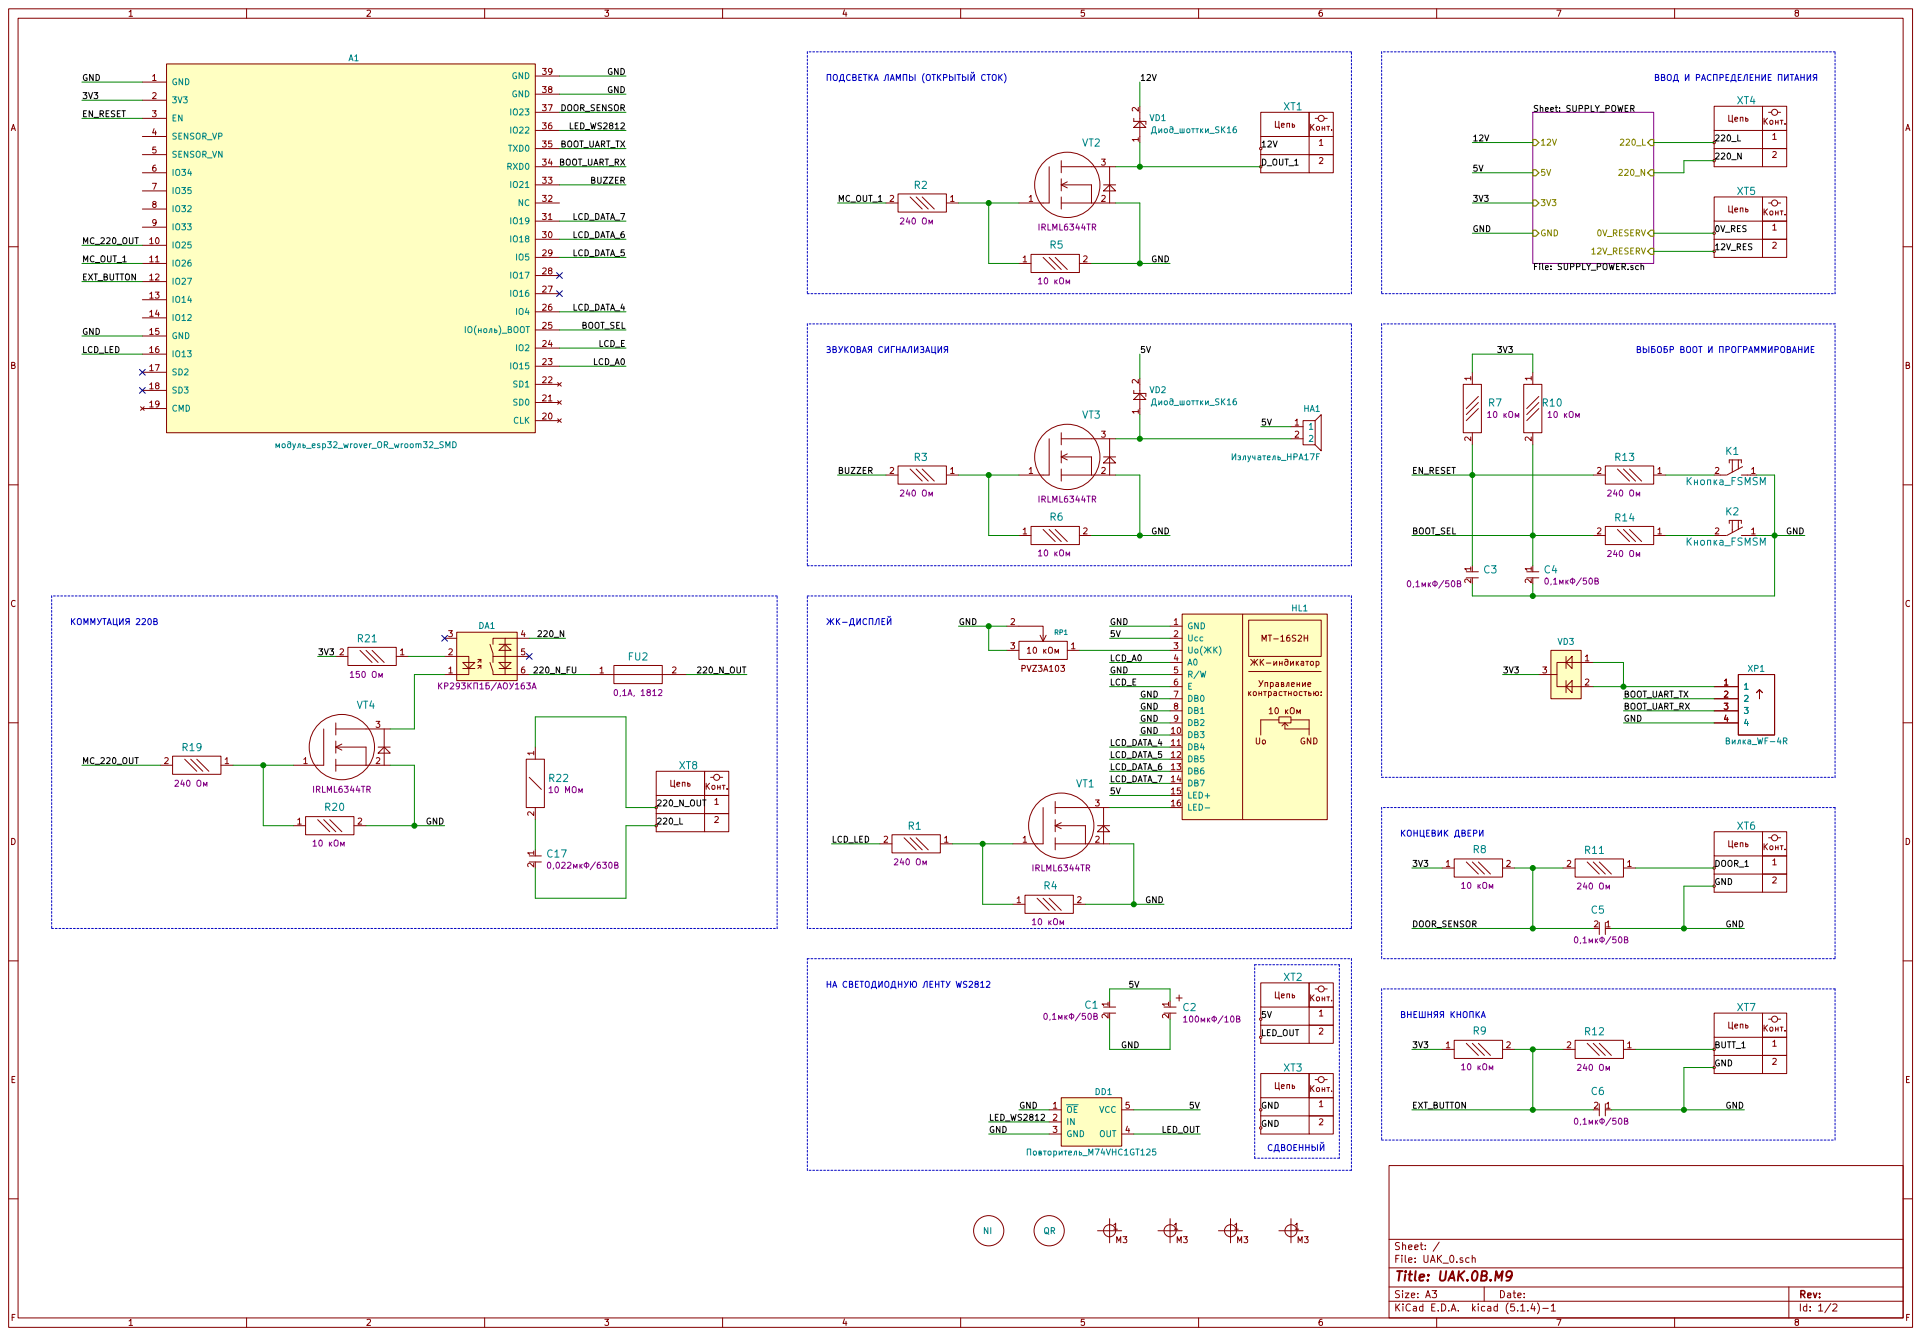
[picture p41: page 1]
