el-nikitos/UAK/UAK_0/PDF/UAK_0A.pdf

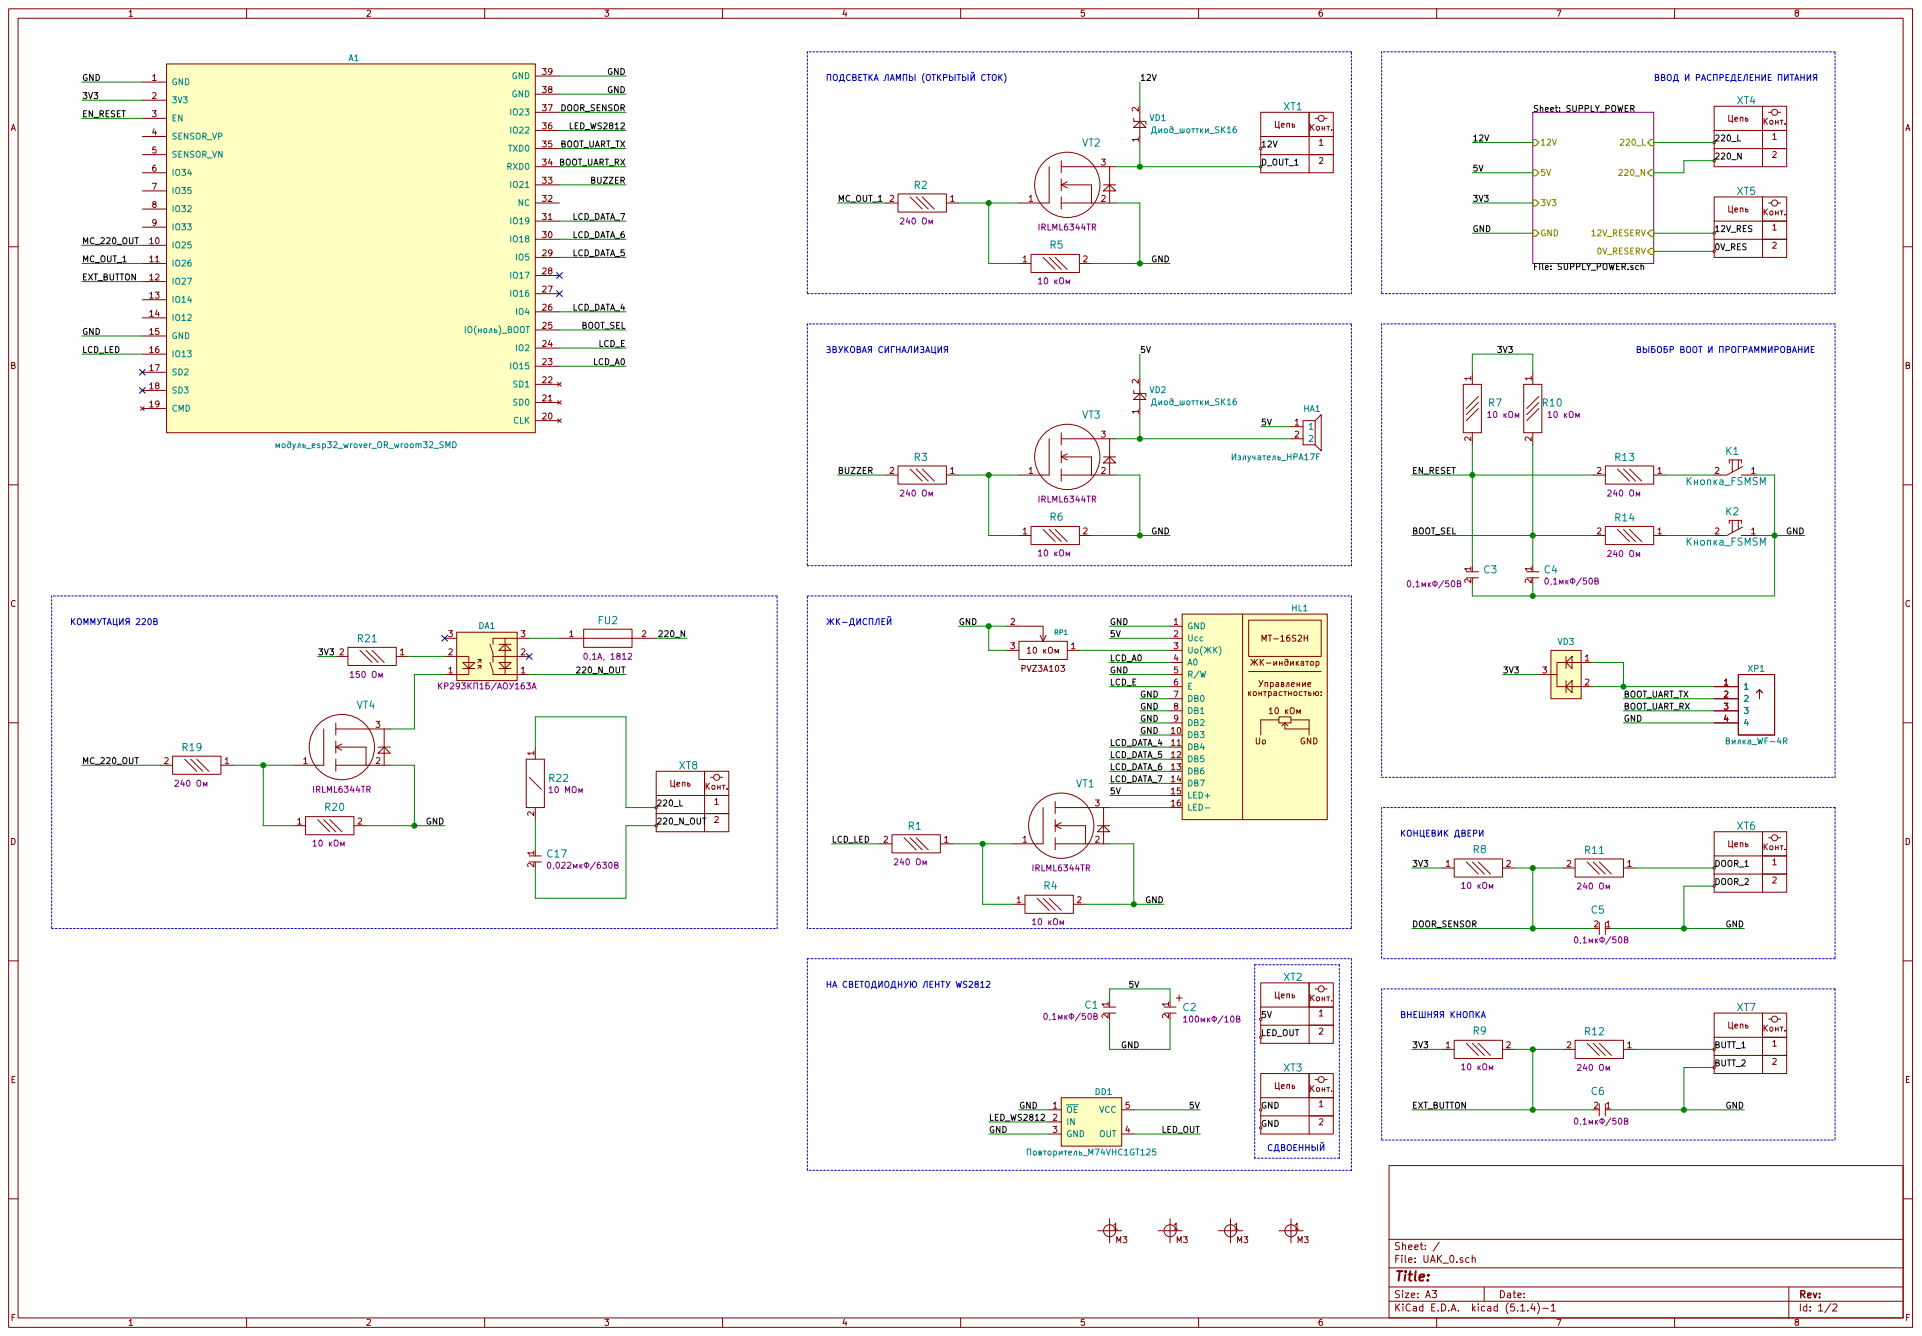
[picture p42: page 1]

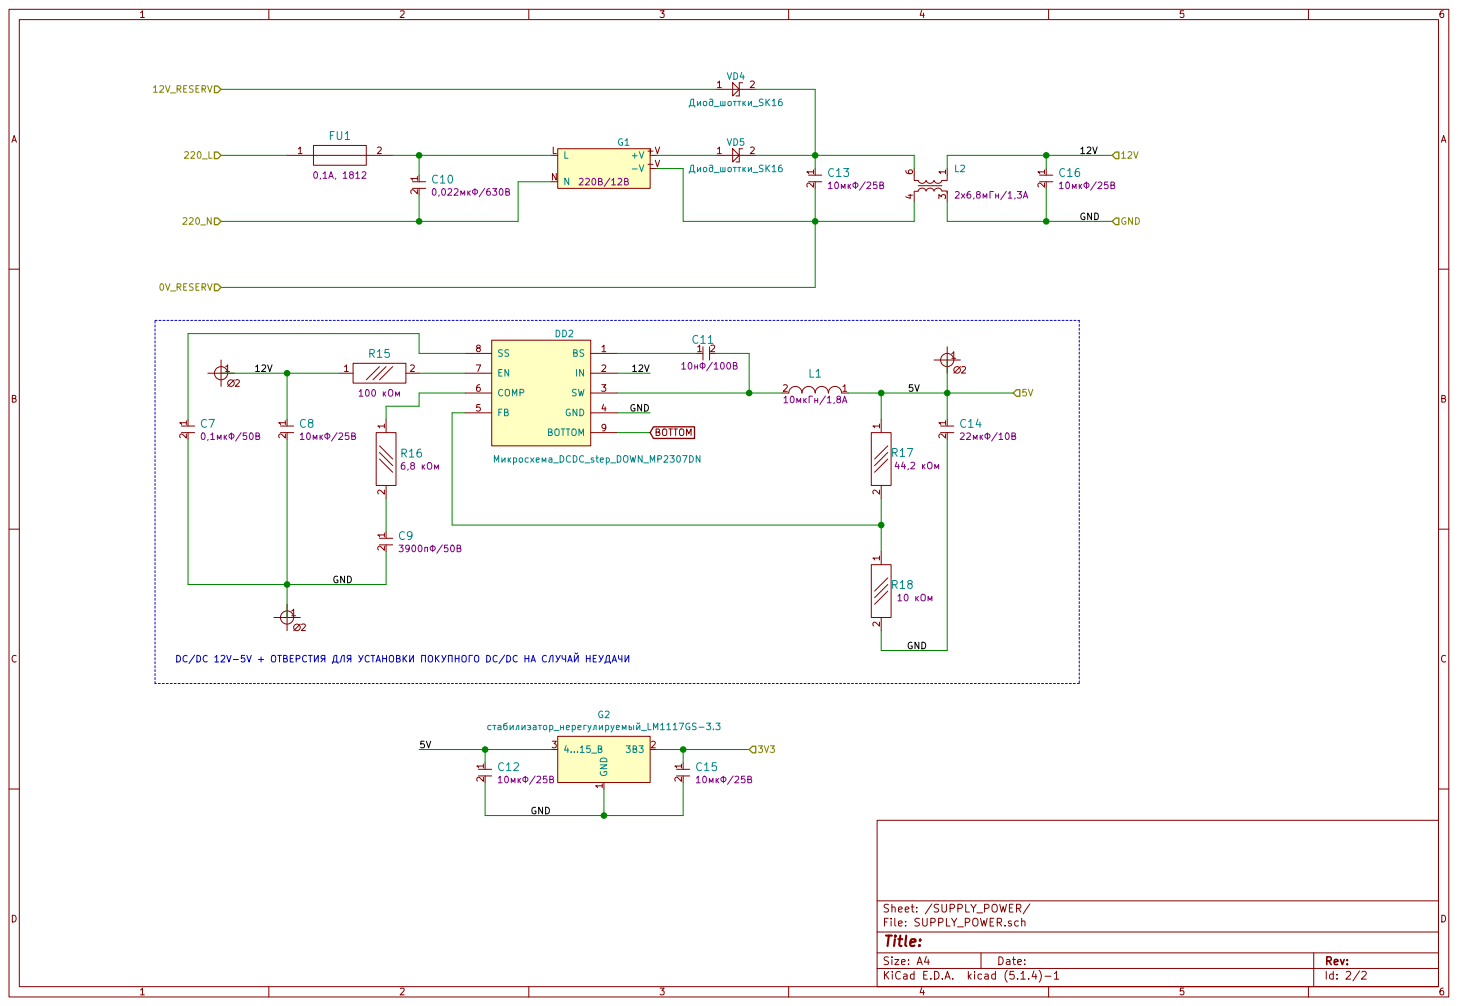
[picture p43: page 2]
