el-nikitos/UAK/UAK_3/UAK_3.kicad_pcb

## KiCad design UAK_3/UAK_3.kicad_pcb (2021-05-09)

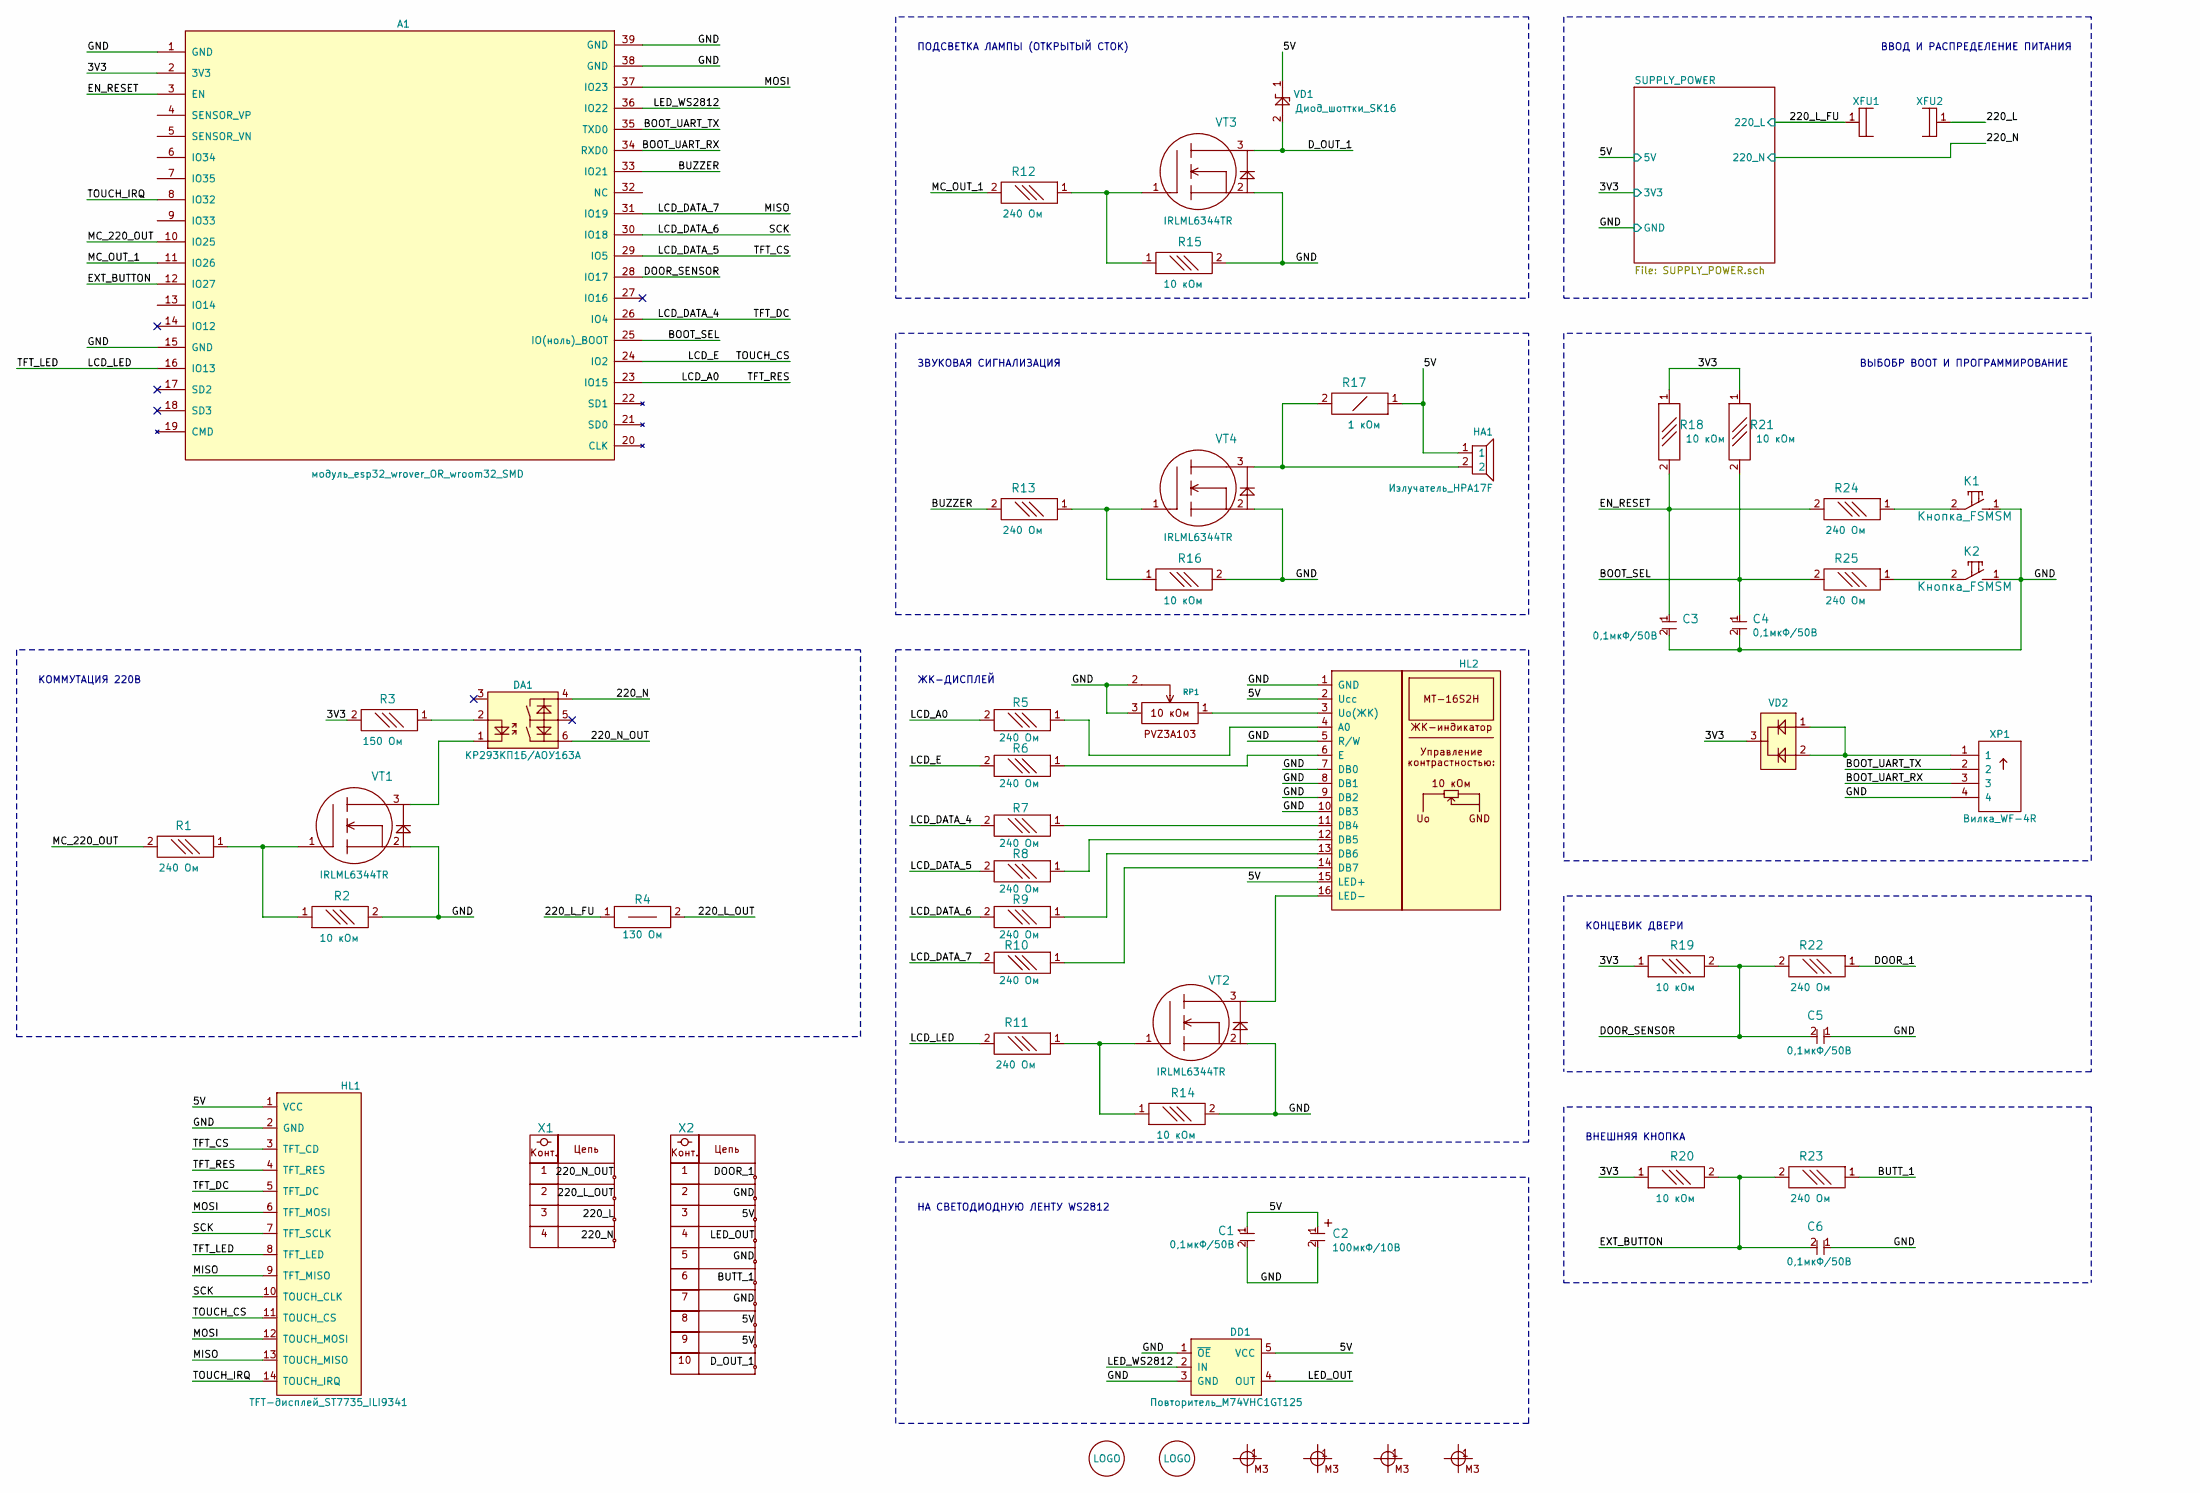
[picture p44: schematic UAK_3.sch, UAK.2B.MN]

Parts:
A1: модуль_esp32_wrover_OR_wroom32_SMD; ESP32_WROVER_or_WROOM32_pnp; LCSC C701341
C1, C3, C4, C5, C6: Конденсатор_керамический; Конденсатор_SMD_0603_pnp; LCSC C14663
C2: Конденсатор_К53-56А-32В-22_мкФ+-10проц.; Конденсатор_тантал_SMD_m7343_pnp; LCSC C313070
D1: LOGO; danger_220
D2: LOGO; bleeper_4x33
DA1: МОП-реле_КР293КП1Б; DIP6
DD1: Повторитель_M74VHC1GT125; SOT-23-5_pnp; LCSC C457671
HA1: Излучатель_HPA17F; Зуммер_HPA17F
HL1: TFT-дисплей_ST7735_ILI9341; TFT_2.8_INCH
HL2: Жидкокристалический_индикатор_MT-16S2H-2KLW; ЖК_MT-16S2H_2DRL
K1, K2: Кнопка_FSMSM
R1, R5, R6, R7, R8, R9, R10, R11, R12, R13, R22, R23, R24, R25: Резистор_0,065Вт; Резистор_SMD_0603_0,065_Вт_pnp; LCSC C101310
R2, R14, R15, R16, R18, R19, R20, R21: Резистор_0,065Вт; Резистор_SMD_0603_0,065_Вт_pnp; LCSC C510290
R3: Резистор_0,065Вт; Резистор_SMD_0603_0,065_Вт_pnp; LCSC C336847
R4: Резистор_0,5Вт; Резистор_SMD_2010-0,5_Вт_pnp; LCSC C406994
R17: Резистор_0,25Вт; Резистор_SMD_1206-0,25_Вт_pnp; LCSC C830401
RP1: Резистор_подстроечный_PVA3A103; резистор_подстроечный_3314J-1_pnp; LCSC C36376
VD1: Диод_шоттки_SK16; Диод_SMB_pnp; LCSC C35501
VD2: Набор_диодов_BAR43CFILM; Корпус_КТ-46_pnp; LCSC C14308
VT1, VT2, VT3, VT4: Транзистор_полевой_N-канальный_IRLML6344TR; Корпус_КТ-46_pnp; LCSC C693370
X1: Клеммник_х4; Клеммник_х4_шаг3,81_15EDGRC
X2: Клеммник_х10; Клеммник_х10_шаг3,81_15EDGRC
X3, X4, X5, X6: Крепежное_отверстие_М3; Крепежное_Отверстие_под_М3
XFU1, XFU2: Держатель_предохранителя_KLS5-266; Держатель_5х20
XP1: Вилка_WF-4R; Вилка_СНП389-4ВП32-1-1

Connections:
/3V3: A1.2 (3V3), R3.2, R18.1, R19.1, R20.1, R21.1, VD2.3; also elsewhere on the board
/5V: C1.1, C2.1, DD1.5 (VCC), HA1.1, HL1.1 (VCC), HL2.2 (Ucc), HL2.15 (LED+), R17.1, VD1.1, X2.3, X2.8, X2.9; also elsewhere on the board
/220_L: X1.3, XFU2.1
/220_L_FU: R4.1, XFU1.1; also elsewhere on the board
/220_L_OUT: R4.2, X1.2
/220_N: DA1.4, X1.4; also elsewhere on the board
/220_N_OUT: DA1.6, X1.1
/BOOT_SEL: A1.25 (IO(ноль)_BOOT), C4.1, R21.2, R25.2
/BOOT_UART_RX: A1.34 (RXD0), XP1.3
/BOOT_UART_TX: A1.35 (TXD0), XP1.2
/BUTT_1: R23.1, X2.6
/BUZZER: A1.33 (IO21), R13.2
/DOOR_1: R22.1, X2.1
/DOOR_SENSOR: A1.28 (IO17), C5.2, R19.2, R22.2
/D_OUT_1: VD1.2, VT3.3, X2.10
/EN_RESET: A1.3 (EN), C3.1, R18.2, R24.2
/EXT_BUTTON: A1.12 (IO27), C6.2, R20.2, R23.2
/GND: A1.1 (GND), A1.15 (GND), A1.38 (GND), A1.39 (GND), C1.2, C2.2, C3.2, C4.2, C5.1, C6.1, DD1.1 (~OE), DD1.3 (GND), HL1.2 (GND), HL2.1 (GND), HL2.5 (R/W), HL2.7 (DB0), HL2.8 (DB1), HL2.9 (DB2), HL2.10 (DB3), K1.1, K2.1, R2.2, R14.2, R15.2, R16.2, RP1.2, RP1.3, VT1.2, VT2.2, VT3.2, VT4.2, X2.2, X2.5, X2.7, XP1.4; also elsewhere on the board
/LCD_A0: A1.23 (IO15), HL1.4 (TFT_RES), R5.2
/LCD_DATA_4: A1.26 (IO4), HL1.5 (TFT_DC), R7.2
/LCD_DATA_5: A1.29 (IO5), HL1.3 (TFT_CD), R8.2
/LCD_DATA_6: A1.30 (IO18), HL1.7 (TFT_SCLK), HL1.10 (TOUCH_CLK), R9.2
/LCD_DATA_7: A1.31 (IO19), HL1.9 (TFT_MISO), HL1.13 (TOUCH_MISO), R10.2
/LCD_E: A1.24 (IO2), HL1.11 (TOUCH_CS), R6.2
/LCD_LED: A1.16 (IO13), HL1.8 (TFT_LED), R11.2
/LED_OUT: DD1.4 (OUT), X2.4
/LED_WS2812: A1.36 (IO22), DD1.2 (IN)
/MC_220_OUT: A1.10 (IO25), R1.2
/MC_OUT_1: A1.11 (IO26), R12.2
/MOSI: A1.37 (IO23), HL1.6 (TFT_MOSI), HL1.12 (TOUCH_MOSI)
/TOUCH_IRQ: A1.8 (IO32), HL1.14 (TOUCH_IRQ)
unnamed: DA1.1, VT1.3
unnamed: DA1.2, R3.1
unnamed: HA1.2, R17.2, VT4.3
unnamed: HL2.3 (Uo(ЖК)), RP1.1
unnamed: HL2.4 (A0), R5.1
unnamed: HL2.6 (E), R6.1
unnamed: HL2.11 (DB4), R7.1
unnamed: HL2.12 (DB5), R8.1
unnamed: HL2.13 (DB6), R9.1
unnamed: HL2.14 (DB7), R10.1
unnamed: HL2.16 (LED-), VT2.3
unnamed: K1.2, R24.1
unnamed: K2.2, R25.1
unnamed: R1.1, R2.1, VT1.1
unnamed: R11.1, R14.1, VT2.1
unnamed: R12.1, R15.1, VT3.1
unnamed: R13.1, R16.1, VT4.1
unnamed: VD2.1, VD2.2, XP1.1

Notes on the sheet:
ВЫБОБР BOOT И ПРОГРАММИРОВАНИЕ
ВВОД И РАСПРЕДЕЛЕНИЕ ПИТАНИЯ
КОНЦЕВИК ДВЕРИ
ПОДСВЕТКА ЛАМПЫ (ОТКРЫТЫЙ СТОК)
ЖК-ДИСПЛЕЙ
ЗВУКОВАЯ СИГНАЛИЗАЦИЯ
ВНЕШНЯЯ КНОПКА
НА СВЕТОДИОДНУЮ ЛЕНТУ WS2812
КОММУТАЦИЯ 220В

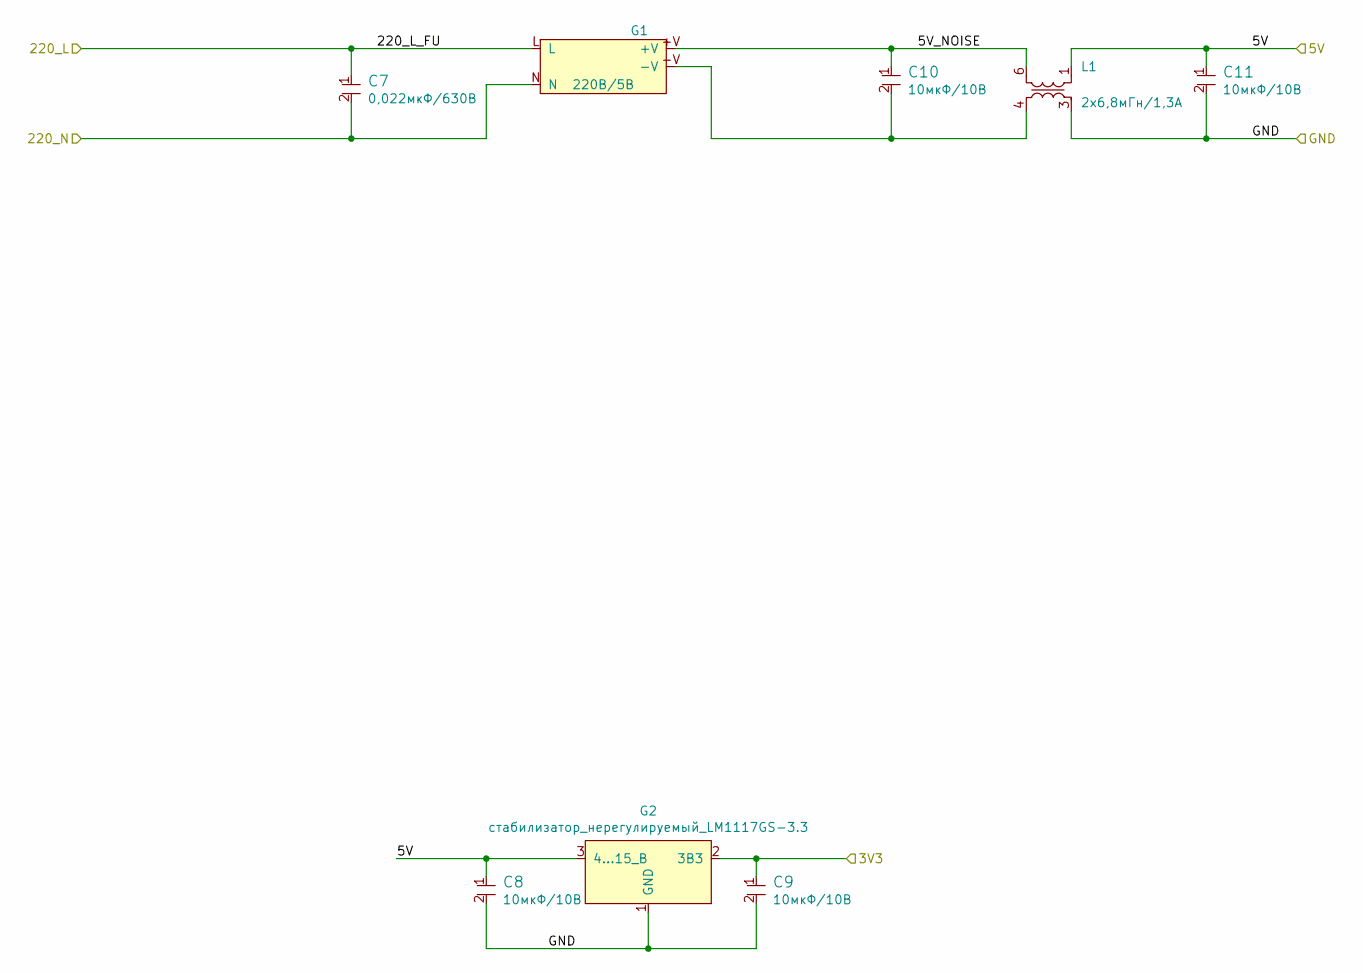
[picture p45: schematic SUPPLY_POWER.sch]

Parts:
C7: Конденсатор_керамический; Конденсатор_SMD_1210_pnp; LCSC C304015
C8, C9, C10, C11: Конденсатор_керамический; Конденсатор_SMD_0603_pnp; LCSC C19702
G1: AC-DC-преобразователь_IRM-15-5; AC-DC_IRM-20-12
G2: стабилизатор_нерегулируемый_LM1117GS-3.3; Транзистор_NPN_SOT223_pnp; LCSC C173386
L1: Дроссель_B82731-T2132-A20_2х6.8мГн_1.3А_250В; Дроссель_B82731

Connections:
/3V3: C9.1, G2.2 (3В3); also elsewhere on the board
/5V: C8.1, C11.1, G2.3 (4...15_В), L1.1; also elsewhere on the board
/220_L_FU: C7.1, G1.L; also elsewhere on the board
/220_N: C7.2, G1.N; also elsewhere on the board
/GND: C8.2, C9.2, C11.2, G2.1 (GND), L1.3; also elsewhere on the board
/SUPPLY_POWER/5V_NOISE: C10.1, G1.+V, L1.6
unnamed: C10.2, G1.-V, L1.4

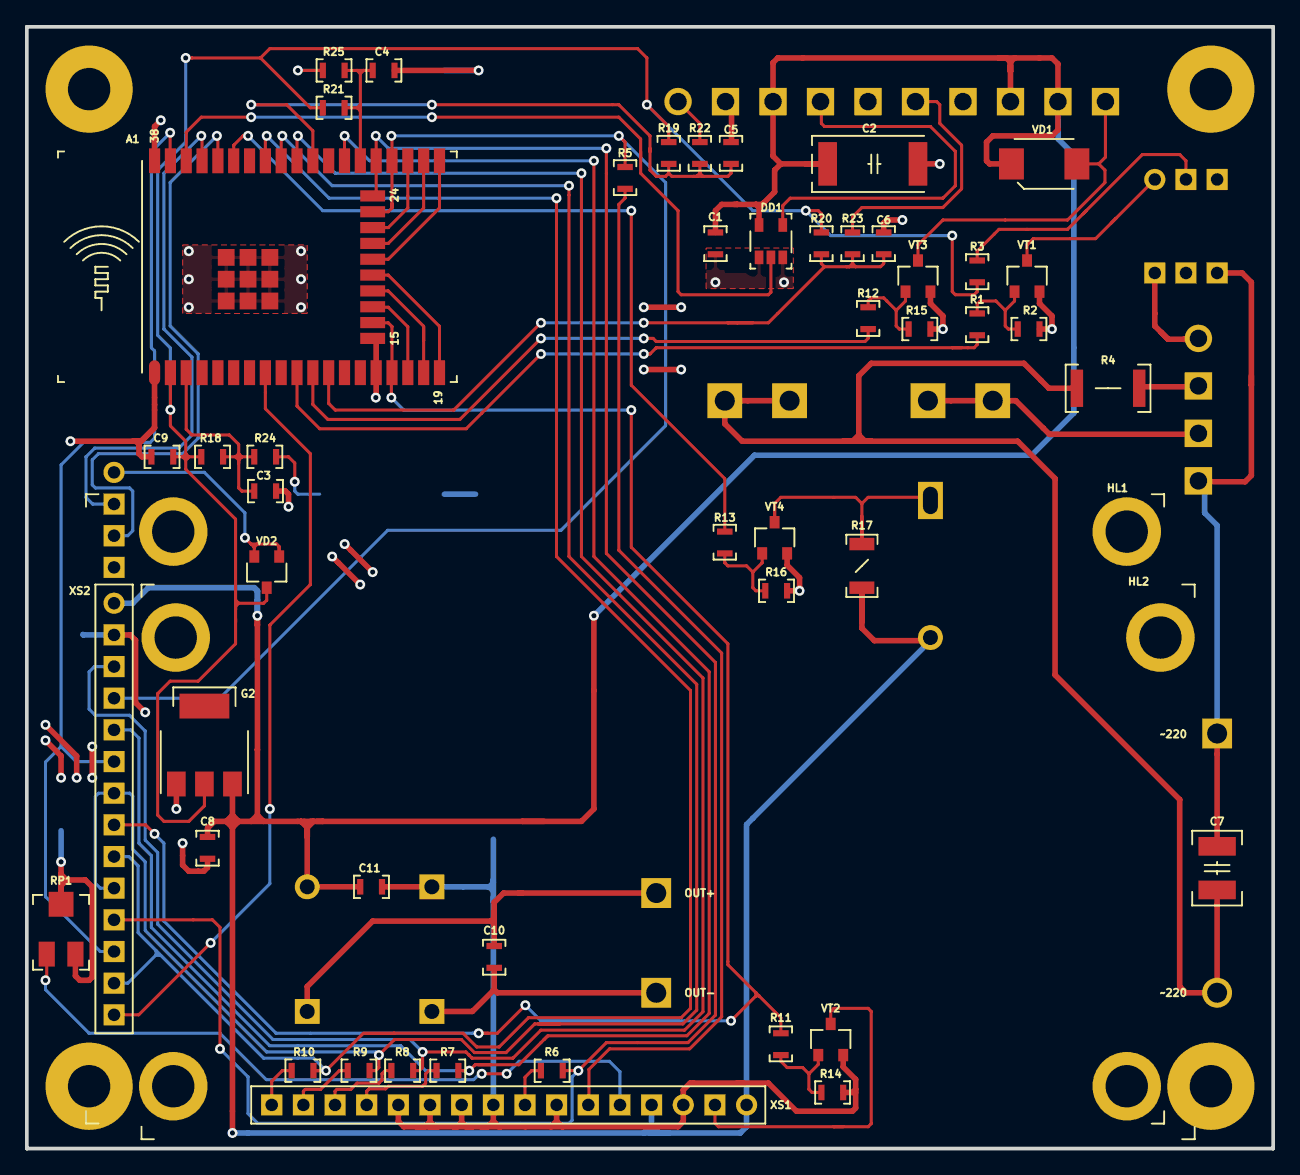
[picture p46: board UAK_3.kicad_pcb from above]

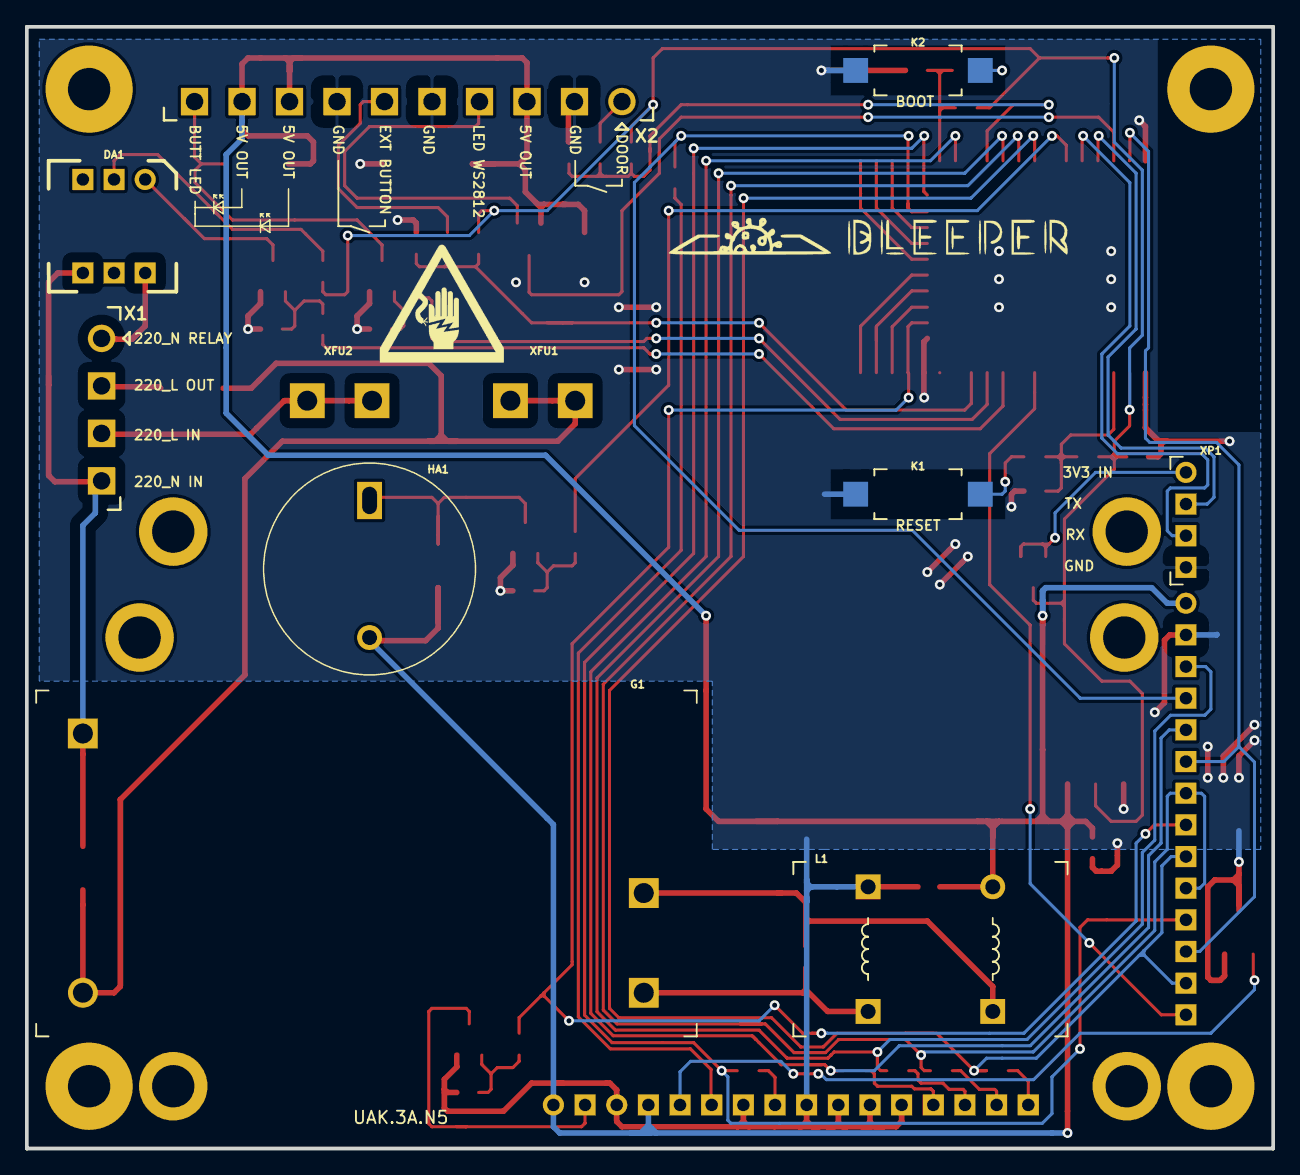
[picture p47: board UAK_3.kicad_pcb from below]

Board: 2 copper layers, 100.0 x 90.0 mm, 65 parts (13 on the bottom side), 51 nets.
