el-nikitos/UAK/UAK_2/UAK_2.kicad_pcb

## KiCad design UAK_2/UAK_2.kicad_pcb (2020-11-07)

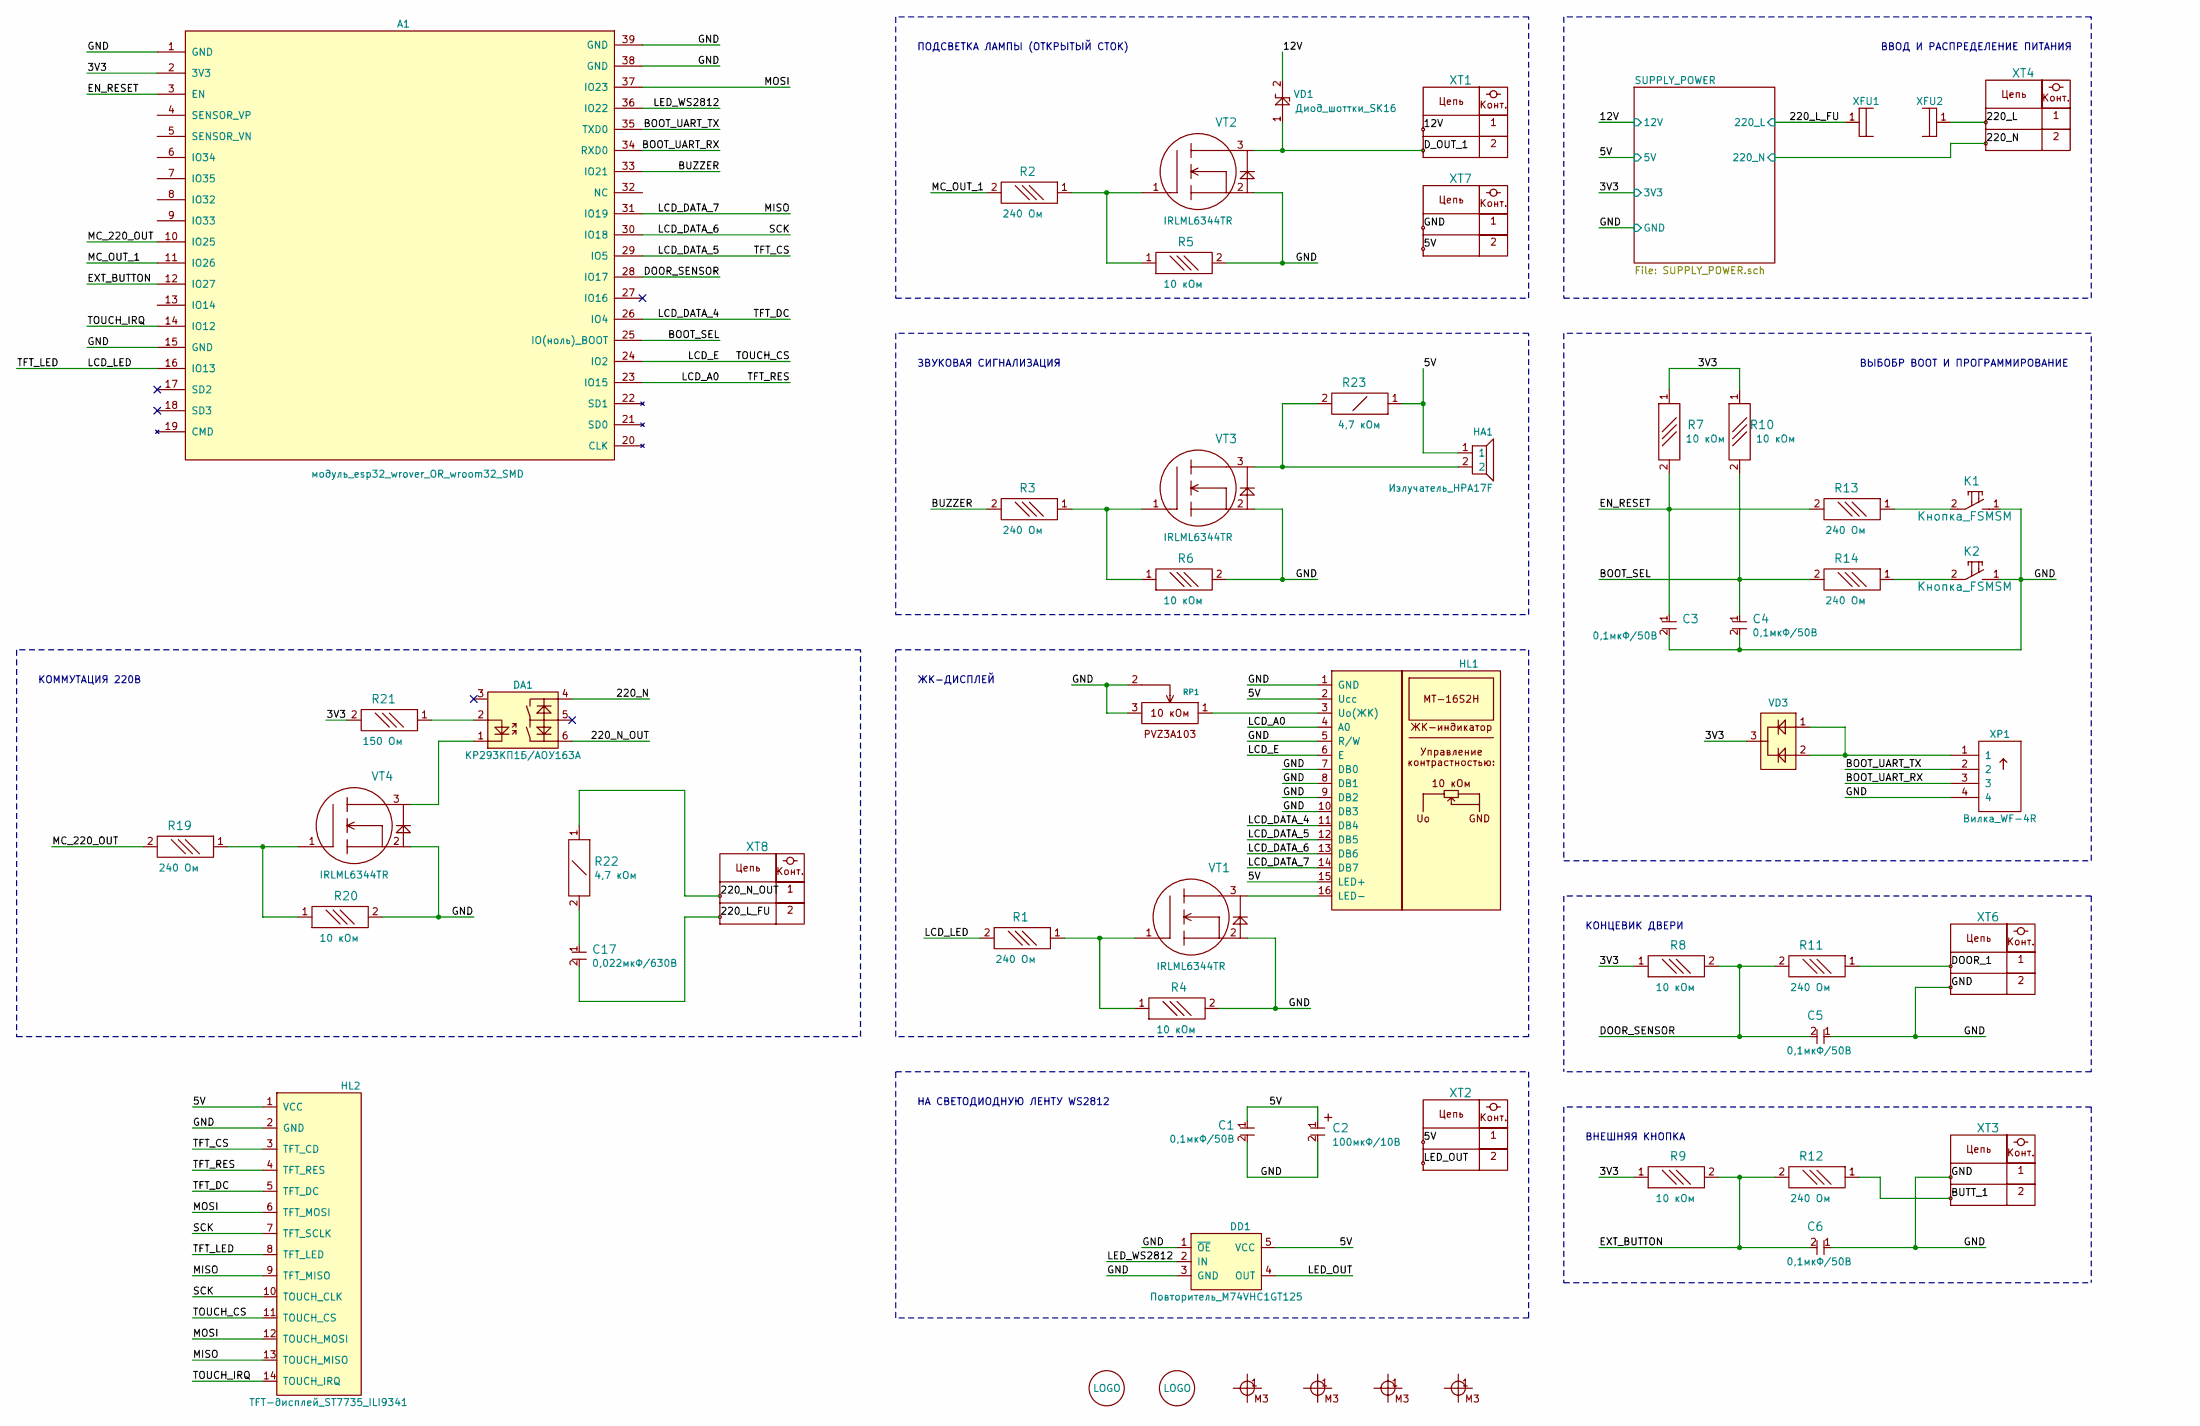
[picture p48: schematic UAK_2.sch, UAK.2B.MN]

Parts:
A1: модуль_esp32_wrover_OR_wroom32_SMD; ESP32_WROVER_or_WROOM32
C1, C3, C4, C5, C6: Конденсатор_керамический; Конденсатор_SMD_0603
C2: Конденсатор_К53-56А-32В-22_мкФ+-10проц.; Конденсатор_тантал_SMD_m7343
C17: Конденсатор_керамический; Конденсатор_SMD_1210
D1: LOGO; bleeper_4x33
D2: LOGO; danger_220
DA1: МОП-реле_КР293КП1Б; DIP6
DD1: Повторитель_M74VHC1GT125; Преобразователь_LM2703_SOT-23-5
HA1: Излучатель_HPA17F; Зуммер_HPA17F
HL1: Жидкокристалический_индикатор_MT-16S2H-2KLW; ЖК_MT-16S2H_2DRL
HL2: TFT-дисплей_ST7735_ILI9341; TFT_2.8_INCH
K1, K2: Кнопка_FSMSM
R1, R2, R3, R4, R5, R6, R7, R8, R9, R10, R11, R12, R13, R14, R19, R20, R21: Резистор_0,065Вт; Резистор_SMD_0603_0,065_Вт
R22, R23: Резистор_0,25Вт; Резистор_SMD_1206-0,25_Вт
RP1: Резистор_подстроечный_PVA3A103; резистор_подстроечный_PVZ3A334
VD1: Диод_шоттки_SK16; Диод_SMB
VD3: Набор_диодов_BAR43CFILM; Корпус_КТ-46
VT1, VT2, VT3, VT4: Транзистор_полевой_N-канальный_IRLML6344TR; Корпус_КТ-46
X1, X2, X3, X4: Крепежное_отверстие_М3; Крепежное_Отверстие_под_М3
XFU1, XFU2: Держатель_предохранителя_KLS5-266; Держатель_5х20
XP1: Вилка_WF-4R; Вилка_СНП389-4ВП32-1-1
XT1, XT2, XT3, XT6, XT7: Клеммник_х2_308-021-14; Клеммник_х2_шаг2.54
XT4, XT8: Клеммник_х2_KLS2-300-5.00-02P-2S; Клеммник_х2_шаг5

Connections:
/3V3: A1.2 (3V3), R7.1, R8.1, R9.1, R10.1, R21.2, VD3.3; also elsewhere on the board
/5V: C1.1, C2.1, DD1.5 (VCC), HA1.1, HL1.2 (Ucc), HL1.15 (LED+), HL2.1 (VCC), R23.1, XT2.1, XT7.2; also elsewhere on the board
/12V: VD1.2, XT1.1; also elsewhere on the board
/220_L: XFU2.1, XT4.1
/220_L_FU: C17.2, XFU1.1, XT8.2; also elsewhere on the board
/220_N: DA1.4, XT4.2; also elsewhere on the board
/220_N_OUT: DA1.6, R22.1, XT8.1
/BOOT_SEL: A1.25 (IO(ноль)_BOOT), C4.1, R10.2, R14.2
/BOOT_UART_RX: A1.34 (RXD0), XP1.3
/BOOT_UART_TX: A1.35 (TXD0), XP1.2
/BUTT_1: R12.1, XT3.2
/BUZZER: A1.33 (IO21), R3.2
/DOOR_1: R11.1, XT6.1
/DOOR_SENSOR: A1.28 (IO17), C5.2, R8.2, R11.2
/D_OUT_1: VD1.1, VT2.3, XT1.2
/EN_RESET: A1.3 (EN), C3.1, R7.2, R13.2
/EXT_BUTTON: A1.12 (IO27), C6.2, R9.2, R12.2
/GND: A1.1 (GND), A1.15 (GND), A1.38 (GND), A1.39 (GND), C1.2, C2.2, C3.2, C4.2, C5.1, C6.1, DD1.1 (~OE), DD1.3 (GND), HL1.1 (GND), HL1.5 (R/W), HL1.7 (DB0), HL1.8 (DB1), HL1.9 (DB2), HL1.10 (DB3), HL2.2 (GND), K1.1, K2.1, R4.2, R5.2, R6.2, R20.2, RP1.2, RP1.3, VT1.2, VT2.2, VT3.2, VT4.2, XP1.4, XT3.1, XT6.2, XT7.1; also elsewhere on the board
/LCD_A0: A1.23 (IO15), HL1.4 (A0), HL2.4 (TFT_RES)
/LCD_DATA_4: A1.26 (IO4), HL1.11 (DB4), HL2.5 (TFT_DC)
/LCD_DATA_5: A1.29 (IO5), HL1.12 (DB5), HL2.3 (TFT_CD)
/LCD_DATA_6: A1.30 (IO18), HL1.13 (DB6), HL2.7 (TFT_SCLK), HL2.10 (TOUCH_CLK)
/LCD_DATA_7: A1.31 (IO19), HL1.14 (DB7), HL2.9 (TFT_MISO), HL2.13 (TOUCH_MISO)
/LCD_E: A1.24 (IO2), HL1.6 (E), HL2.11 (TOUCH_CS)
/LCD_LED: A1.16 (IO13), HL2.8 (TFT_LED), R1.2
/LED_OUT: DD1.4 (OUT), XT2.2
/LED_WS2812: A1.36 (IO22), DD1.2 (IN)
/MC_220_OUT: A1.10 (IO25), R19.2
/MC_OUT_1: A1.11 (IO26), R2.2
/MOSI: A1.37 (IO23), HL2.6 (TFT_MOSI), HL2.12 (TOUCH_MOSI)
/TOUCH_IRQ: A1.14 (IO12), HL2.14 (TOUCH_IRQ)
unnamed: C17.1, R22.2
unnamed: DA1.1, VT4.3
unnamed: DA1.2, R21.1
unnamed: HA1.2, R23.2, VT3.3
unnamed: HL1.3 (Uo(ЖК)), RP1.1
unnamed: HL1.16 (LED-), VT1.3
unnamed: K1.2, R13.1
unnamed: K2.2, R14.1
unnamed: R1.1, R4.1, VT1.1
unnamed: R2.1, R5.1, VT2.1
unnamed: R3.1, R6.1, VT3.1
unnamed: R19.1, R20.1, VT4.1
unnamed: VD3.1, VD3.2, XP1.1

Notes on the sheet:
ВЫБОБР BOOT И ПРОГРАММИРОВАНИЕ
ВВОД И РАСПРЕДЕЛЕНИЕ ПИТАНИЯ
КОНЦЕВИК ДВЕРИ
ПОДСВЕТКА ЛАМПЫ (ОТКРЫТЫЙ СТОК)
ЖК-ДИСПЛЕЙ
ЗВУКОВАЯ СИГНАЛИЗАЦИЯ
ВНЕШНЯЯ КНОПКА
НА СВЕТОДИОДНУЮ ЛЕНТУ WS2812
КОММУТАЦИЯ 220В

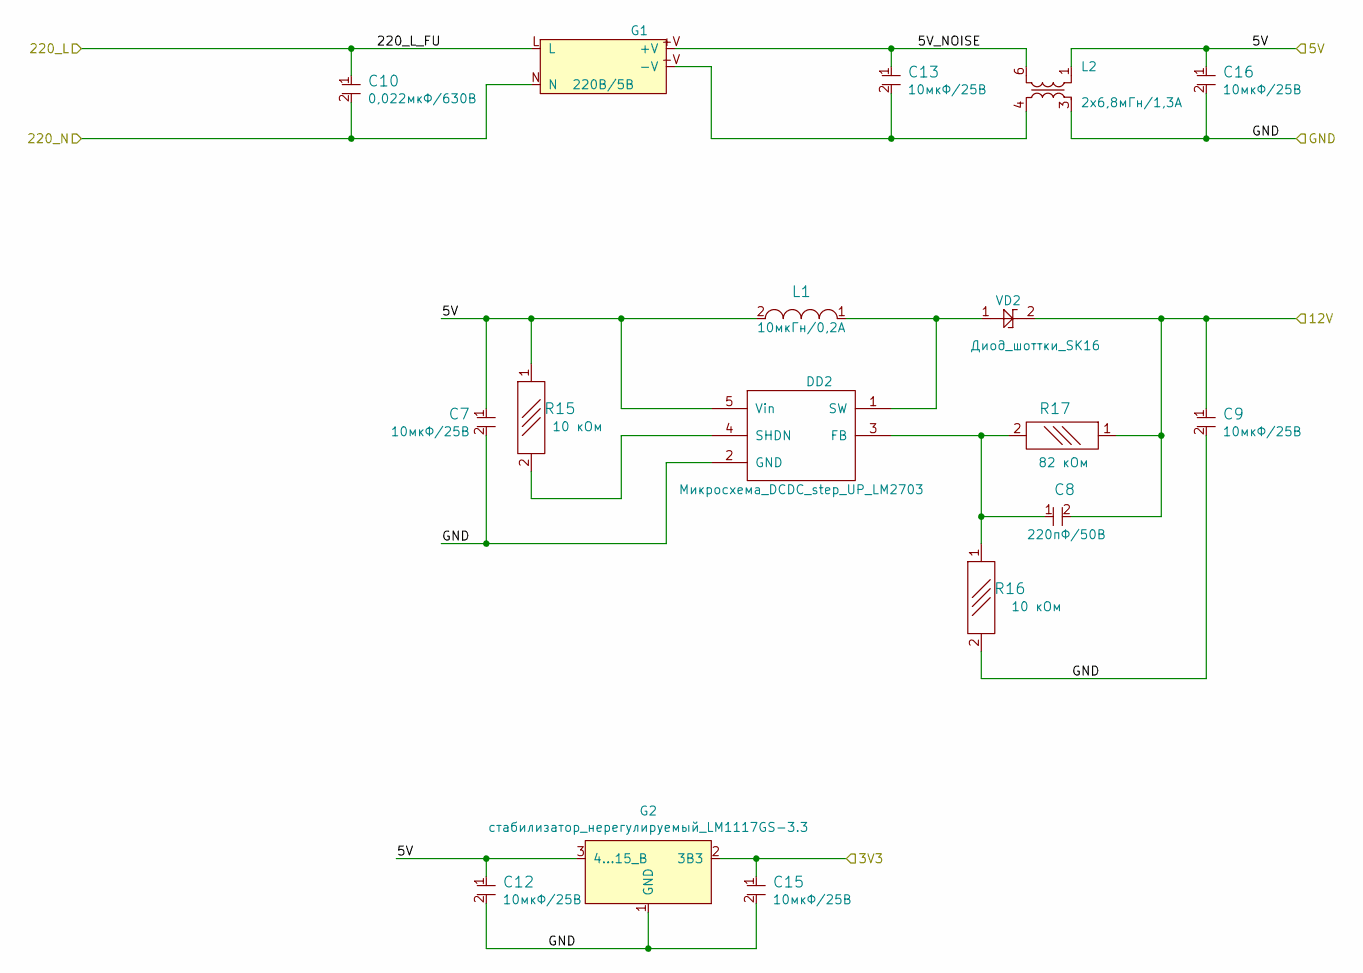
[picture p49: schematic SUPPLY_POWER.sch]

Parts:
C7, C8, C9, C12, C13, C15, C16: Конденсатор_керамический; Конденсатор_SMD_0603
C10: Конденсатор_керамический; Конденсатор_SMD_1210
DD2: Микросхема_DCDC_step_UP_LM2703; Преобразователь_LM2703_SOT-23-5
G1: AC-DC-преобразователь_IRM-15-5; AC-DC_IRM-20-12
G2: стабилизатор_нерегулируемый_LM1117GS-3.3; Транзистор_NPN_SOT223
L1: Чип-индуктивность_10мкГн_0.2А_20проц.; Чип-индуктивность_SMD_0805
L2: Дроссель_B82731-T2132-A20_2х6.8мГн_1.3А_250В; Дроссель_B82731
R15, R16, R17: Резистор_0,065Вт; Резистор_SMD_0603_0,065_Вт
VD2: Диод_шоттки_SK16; Диод_SMB

Connections:
/3V3: C15.1, G2.2 (3В3); also elsewhere on the board
/5V: C7.1, C12.1, C16.1, DD2.5 (Vin), G2.3 (4...15_В), L1.2, L2.1, R15.1; also elsewhere on the board
/12V: C8.2, C9.1, R17.1, VD2.2; also elsewhere on the board
/220_L_FU: C10.1, G1.L; also elsewhere on the board
/220_N: C10.2, G1.N; also elsewhere on the board
/GND: C7.2, C9.2, C12.2, C15.2, C16.2, DD2.2 (GND), G2.1 (GND), L2.3, R16.2; also elsewhere on the board
/SUPPLY_POWER/5V_NOISE: C13.1, G1.+V, L2.6
unnamed: C8.1, DD2.3 (FB), R16.1, R17.2
unnamed: C13.2, G1.-V, L2.4
unnamed: DD2.1 (SW), L1.1, VD2.1
unnamed: DD2.4 (SHDN), R15.2

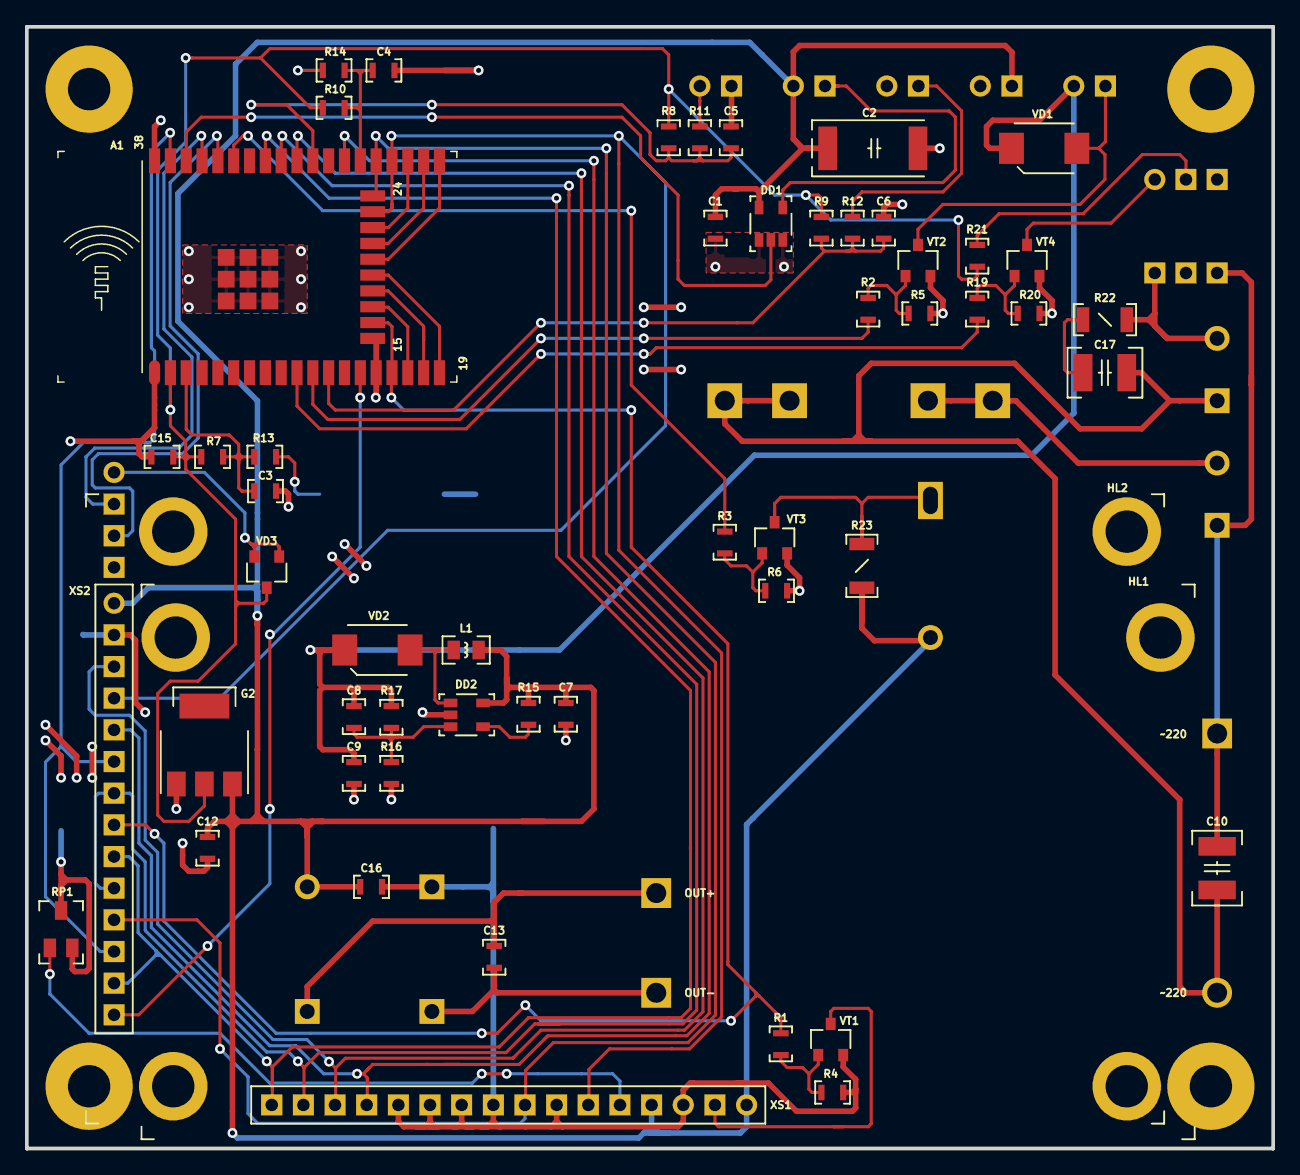
[picture p50: board UAK_2.kicad_pcb from above]

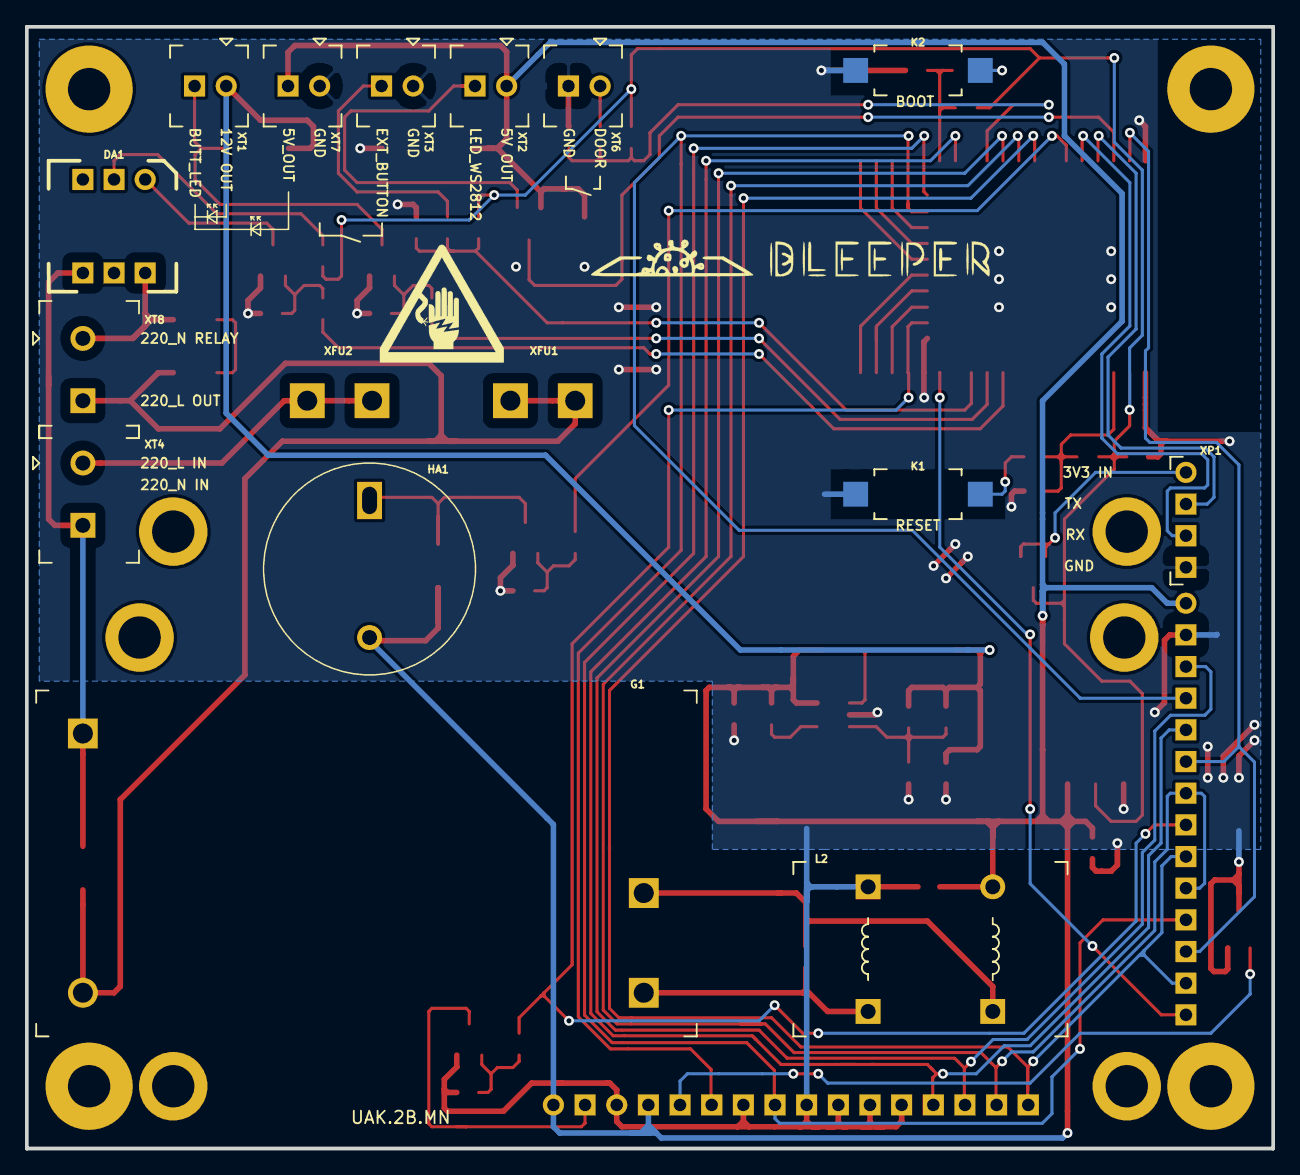
[picture p51: board UAK_2.kicad_pcb from below]

Board: 2 copper layers, 100.0 x 90.0 mm, 74 parts (18 on the bottom side), 49 nets.
