el-nikitos/UAK/(commit log)

2020-08-06 Процессорный модуль с USB и выходами типа открытый сток
2020-09-05 Процессорный модуль ESP32
2020-09-05 начата схема, есть лист питания
    [SUPPLY_POWER.sch, UAK_0.kicad_pcb, UAK_0.sch]
2020-09-06 BOOT&PRG, концевик, ЖК, звук, подсветка - без трассировки
    [SUPPLY_POWER.sch, UAK_0.kicad_pcb, UAK_0.sch]
2020-09-06 нет коммутации 220В, остальная схема есть, нет трассировка
    [SUPPLY_POWER.sch, UAK_0.kicad_pcb, UAK_0.sch]
2020-09-06 подготовлена схема, нет трассировки
    [SUPPLY_POWER.sch, UAK_0.sch]
2020-09-06 подготовлена схема UAK_0A
    [UAK_0.kicad_pcb, UAK_0.sch]
2020-09-06 есть трассировка питания
    [SUPPLY_POWER.sch, UAK_0.kicad_pcb, UAK_0.sch]
2020-09-07 начата установка ESP32
    [SUPPLY_POWER.sch, UAK_0.kicad_pcb, UAK_0.sch]
2020-09-07 закончена трассировка, обновлена PDF и PNG, добавлен STEP
    [SUPPLY_POWER.sch, UAK_0.kicad_pcb, UAK_0.sch]
2020-09-08 UAK_0C. Убрал лого Ni, добавлены gerber
    [SUPPLY_POWER.sch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]
2020-09-19 правки атрибутов УГО, заменен резистор RC-фильтра
    [SUPPLY_POWER.sch, UAK_0.sch]
2020-09-19 добавлена прошивка в arduino ide для проверки функционирования
2020-09-19 UAK.1A.M9
    исправлено межоснвое растояние крепежки экрана, заменен диод закольцовки зумера на сопротивление 4,7 кОм
    [UAK_0.kicad_pcb, UAK_0.sch]
2020-09-22 ссылка на сайт заменена на лого
    [UAK_0.kicad_pcb, UAK_0.sch]
2020-09-23 исправлено лого bleeper, исправлено место зуммера
    [UAK_0.kicad_pcb]
2020-09-23 начата подготовка ТО, начат проект вер.1
    [SUPPLY_POWER.sch, UAK_1.kicad_pcb, UAK_1.sch]
2020-09-25 1B: заменены предохранители,обновлено питание,не добавлен второй дисплей
    [SUPPLY_POWER.sch, UAK_1.kicad_pcb, UAK_1.sch]
2020-09-25 обновлен перечень элементов
    [BOM_1B.xlsx, SUPPLY_POWER.sch, UAK_1.kicad_pcb, UAK_1.sch]
2020-09-26 UAK.1C.M9, подготовлены gerber, схема, BOM
    обновлена маркировка, заполнен BOM
    [BOM_1B.xlsx, BOM_UAK_1С.xlsx, SUPPLY_POWER.sch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]
2020-09-28 рыба заявки в м-плата
    [BOM_UAK_1С.xlsx, SamplePBC.xls]
2020-09-29 добавлена схема элементов для монтажа ревизии 0C
    [BOM_UAK_0С.xlsx]
2020-10-03 обновлены 3D в проекте и step
    [UAK_0.kicad_pcb, UAK_1.kicad_pcb]
2020-10-03 ПЭ и СБ на UAK.1C
    [BOM_UAK_1С.xlsx, UAK_1C ПЭ.xlsx]
2020-10-03 подготавливается wiki_документ и сопутствующие файлы
    [BOM_UAK_0С.xlsx, SUPPLY_POWER.sch, UAK_0.sch]
2020-10-17 исправлен номинал преда. в wiki, добавлена 3D кожуха преда.
    [крышка предохранителя.stl]
2020-10-18 тестовая прошивка uab-1c, рыба прошивки TFT, документ с зав/ном
    [BOM_UAK_1С.xlsx]
2020-11-01 обновлены зав.ном, прошивка TFT_test заливает экран, UAK_2 init
    [SUPPLY_POWER.sch, UAK_2.kicad_pcb, UAK_2.sch]
2020-11-04 добавлена методика программирования, на схему вынесен новый дисплей
    [SUPPLY_POWER.sch, UAK_2.sch]
2020-11-04 крышка предохранителя
    [крышка предохранителя-2.stl]
2020-11-04 UAK.2A.MN + PDF +STEP
    [SUPPLY_POWER.sch, UAK_2.kicad_pcb, UAK_2.sch]
2020-11-07 заменен буфер, перекинуты ножки контроллера,, обновлены PCB +STEP +PDF
    [UAK_2.kicad_pcb, UAK_2.sch]
2020-11-07 UAK_2B: GERBER +СБ +ПЭ
    исправлено посадочное зуммера, подготовлена документация
    [BOM_UAK_2B.xlsx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]
2020-11-08 добавлены исполнения в СБ
2020-11-14 по замечанию резонита нанесена маркировка в СБ
    [UAK_2-B_SilkS.dxf, UAK_2-F_SilkS.dxf]
2020-12-05 в тестовой прошиве ревизии UAK_2 проверка стала двухстрочной
    [UAK_2B ПЭ.xlsx]
2021-02-06 компилирующаяся прошивка
2021-02-22 в тестовой прошивке добавлена подтяжка pull-down
2021-04-24 убран DC/DC 5/12В, перекинут канал прерывания TFT
    [SUPPLY_POWER.sch, UAK_3.kicad_pcb, UAK_3.sch]
2021-04-24 добавлены сопротивления: в управление ЖК и выход 220
    [UAK_3.kicad_pcb, UAK_3.sch]
2021-04-25 заменены клеммники
    [SUPPLY_POWER.sch, UAK_3.kicad_pcb, UAK_3.sch]
2021-04-25 заменен потенциометр, начал формировать BOM
    [JLCSMT_Sample_BOM1.xlsx, SUPPLY_POWER.sch, UAK_3.kicad_pcb, UAK_3.sch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]
2021-05-08 BOM переопределен по всему, кроме резисторов
    [SUPPLY_POWER.sch, UAK_3.sch]
2021-05-08 подготовлены файлы для заказа в JLCPCB
    [JLCSMT_Sample_BOM1.xlsx, JLCSMT_UAK_3A_N5_BOM1.xlsx, SUPPLY_POWER.sch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]
2021-05-09 BOM и CPL поправлены под китай, убрана мира слоев
    [JLCSMT_UAK_3A_N5_BOM1.xlsx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]
